jeffsponaugle/roscoe/V2/docs/V2ExpansionConntectorPinouts.pdf

PIN | DESC | DIR | PIN | DESC | DIR | PIN | DESC | DIR | PIN | DESC | DIR
A1 | EXP_A0 EXP_A2 EXP_A4 EXP_A6 | O | B1 | EXP_A1 EXP_A3 EXP_A5 EXP_A7 | O | C1 | EXP_D0 EXP_D2 EXP_D4 EXP_D6 | I/O | D1 | EXP_D1 EXP_D3 EXP_D5 EXP_D7 | I/O
A2 | | O | B2 | | O | C2 | | I/O | D2 | | I/O
A3 | | O | B3 | | O | C3 | | I/O | D3 | | I/O
A4 | | O | B4 | | O | C4 | | I/O | D4 | | I/O
A5 | EXP_A8 | O | B5 | EXP_A9 | O | C5 | GND | O | D5 | GND | O
A6 | EXP_A10 EXP_A12 EXP_A14 EXP_A16 | O | B6 | EXP_A11 EXP_A13 EXP_A15 EXP_A17 | O | C6 | EXP_D8 EXP_D10 EXP_D12 EXP_D14 | I/O | D6 | EXP_D9 EXP_D11 EXP_D13 EXP_D15 | I/O
A7 | | O | B7 | | O | C7 | | I/O | D7 | | I/O
A8 | | O | B8 | | O | C8 | | I/O | D8 | | I/O
A9 | | O | B9 | | O | C9 | | I/O | D9 | | I/O
A10 | VCC +5V | O | B10 | VCC +5V | O | C10 | EXP_D16 | I/O | D10 | EXP_D17 | I/O
A11 | EXP_A18 EXP_A20 EXP_A22 | O | B11 | EXP_A19 EXP_A21 EXP_A23 | O | C11 | EXP_D18 EXP_D20 EXP_D22 | I/O | D11 | EXP_D19 EXP_D21 EXP_D23 | I/O
A12 | | O | B12 | | O | C12 | | I/O | D12 | | I/O
A13 | | O | B13 | | O | C13 | | I/O | D13 | | I/O
A14 | EXP_A24 | O | B14 | EXP_A25 | O | C14 | VCC +5V | O | D14 | VCC +5V | O
A15 | EXP_A26 | O | B15 | EXP_A27 | O | C15 | EXP_D24 | I/O | D15 | EXP_D25 | I/O
A16 | GND | O | B16 | GND | O | C16 | EXP_D26 | I/O | D16 | EXP_D27 | I/O
A17 | EXP_A28 EXP_A30 | O | B17 | EXP_A29 EXP_A31 | O | C17 | EXP_D28 EXP_D30 | I/O | D17 | EXP_D29 EXP_D31 | I/O
A18 | | O | B18 | | O | C18 | | I/O | D18 | | I/O
A19 | EXP_RW EXP_16B_CS | O | B19 | EXP_8B_CS EXP_32B_CS | O
A20 | | O | B20 | | O
A21 EXP_VMEM_CS O | | | B21 | EXP_INT3A | I/PU
A22 | EXP_INT5D EXP_INT3B | I/PU | B22 | EXP_INT4C EXP_INT2B | I/PU
A23 | | I/PU | B23 | | I/PU
A24 | EXP_INT2A(VID) | I/PU | B24 | EXP_CPU_SIZE0 | O
A25 | EXP_CPU_AS | O | B25 EXP_CPU_SIZE1 O
A26 | EXP_nCPU_DEV_WAIT I/PU | | B26 | EXP_BC_CPLD1 | I/O
A27 | EXP_nDATA_EN | I/PU | B27 | EXP_CPU_CLK | O
A28 | EXP_CACHE_CTRL | I/PU | B28 | EXP_nSYS_RESET O
A29 | EXP_INT5A | I/PU | B29 | EXP_INT_CPLD2 I/O
A30 | EXP_VIO_CS | O | B30 | EXP_BC_CPLD2 | I/O
A31 | EXP_DM_CPLD1 | I/O | B31 | EXP_DM_CPLD2 I/O
