jeffsponaugle/roscoe/V2/docs/InterruptVectors.pdf

IRQ | System Use | MASK Address MASK ( 1= ENABLED, 0=DISABLED)
IRQL7A | 11110000 | (0xF0) | Debugger (Button) | 0x3000 0200 | 0b10000000
IRQL6A | 11100001 | (0xE1) | PTC #1 (Programmable Timer) | 0x3000 0200 | 0b01000000
IRQL6B | 11100010 | (0xE2) | PTC #2 (Programmable Timer) | 0x3000 0200 | 0b00100000
IRQL5A | 11010001 | (0xD1) | NIC | 0x3000 0200 | 0b00010000
IRQL5B | 11010010 | (0xD2) | IDE 1 | 0x3000 0200 | 0b00001000
IRQL5C | 11010100 | (0xD4) | IDE 2 | 0x3000 0200 | 0b00000100
IRQL5D | 11011000 | (0xD8) | EXPANSION_I5 | 0x3000 0200 | 0b00000010
IRQL4A | 11000001 | (0xC1) | UART 1 | 0x3000 0200 | 0b00000001
IRQL4B | 11000010 | (0xC2) | UART 2 | 0x3000 0201 | 0b10000000
IRQL4C | 11000100 | (0xC4) | EXPANSION_I4 | 0x3000 0201 | 0b01000000
IRQL3A | 10110001 | (0xB1) | USB | 0x3000 0201 | 0b00100000
IRQL3B | 10110010 | (0xB2) | EXPANSION_I3 | 0x3000 0201 | 0b00010000
IRQL2A | 10100001 | (0xA1) | VIDEO | 0x3000 0201 | 0b00001000
IRQL2B | 10100010 | (0xA2) | EXPANSION_I2 | 0x3000 0201 | 0b00000100
IRQL1A | 10010001 | (0x91) | RTC | 0x3000 0201 | 0b00000010
IRQL1B | 10010010 | (0x92) | POWER CONTROLLER | 0x3000 0201 | 0b00000001

MASK must be written with 8 bit writes (2 of them)

0x3000 0202 | Bit 0 = POWER OFF if == 1
| Bit 1 = SYSTEM RESET if == 1

Vector#
