jeffsponaugle/roscoe/V2/docs/Roscoe 68030 MemoryMap.xlsx

Sheet: MemoryMap(Current)
Memory Map |  |  |  |  |  |  | Smallest unit of device chip select is 256b (so a max of 24 address bits needed for decode). This could be increased to reduce decode complexity and reduce address lines needed in CPLD
REGION |  | SECTION
Start | Stop |  |  | Size/Spacing (in K) | Access | Type | Description
0x00000000 | 0x0FFFFFFF |  |  | 256MB |  | SYSTEM AND EXPANSION ROM AREA
 |  | 0x00000000 | 0x0007FFFF | #NUM! | R(W) | Primary System BIOS ( 8 bit access )
 |  | 0x00080000 | 0x000FFFFF | #NUM! | R(W) | Primary System BIOS ( 8 bit access ) [MIRROR]
 |  | 0x00010000 | 0x0FFFFFFF | #NUM! | R(W) | REPEAT EVERY 512K ^--
0x10000000 | 0x1FFFFFFF |  |  | 256MB |  | FAST SRAM AREA
 |  | 0x10000000 | 0x103FFFFF | 4MB | RW | 4MB of 0WS FAST SYNC SRAM (12ns)
 |  | 0x10400000 | 0x1FFFFFFF | 252MB |  | UNASSIGNED
0x20000000 | 0x2FFFFFFF |  |  | 256MB |  | EXTRA SRAM AREA
 |  | 0x20000000 | 0x2FFFFFFF | 256MB | RW | Unused in current design
0x30000000 | 0x3FFFFFFF |  |  | 256MB |  | 8-BIT DEVICE MAPPING
 |  | 0x30000000 | 0x300000FF | 256B | RW | TL16C2552 Dual UART A
 |  | 0x30000100 | 0x300001FF | 256B | RW | TL16C2552 Dual UART B
 |  | 0x30000200 | 0x30000201 | 2B | W | Interrupt Controller Interface | Interrupt Mask Register Byte Write to high,then low. 1=Enable Interrupt, 0=Disable Interrupt RESETs to all 0 0x30000200 bit 7 INT 7 INT_MSK15 bit 6 INT 6A INT_MSK14 bit 5 INT 6B INT_MSK13 bit 4 INT 5A INT_MSK12 bit 3 INT 5B INT_MSK11 bit 2 INT 5C INT_MSK10 bit 1 INT 5D INT_MSK9 bit 0 INT 4A INT_MSK8 0x30000201 bit 7 INT 4B INT_MSK7 bit 6 INT 4C INT_MSK6 bit 5 INT 3A INT_MSK5 bit 4 INT 3B INT_MSK4 bit 3 INT 2A INT_MSK3 bit 2 INT 2B INT_MSK2 bit 1 INT 1A INT_MSK1 bit 0 INT 1B INT_MSK0
 |  | 0x30000202 | 0x30000202 | 1B | W | Power and reset control | Bit 1 - 1=Reset system Bit 0 - 1=Power down system
 |  | 0x30000300 | 0x300003FF | 256B | RW | RTC + 114 byte RAM (DS12887/DS1687)
 |  | 0x30000400 | 0x300004FF | 256B | RW | UNUSED
 |  | 0x30000500 | 0x300005FF | 256B | RW | UNUSED ( for Video Controller Interface)
 |  | 0x30000600 | 0x300006FF | 256B | RW | Seven Segment Display, Left Character | D0-D7 = A,B,C,D,E,F,G,DP
 |  | 0x30000700 | 0x300007FF | 256B | RW | Seven Segment Display, Right Character | D0-D7 = A,B,C,D,E,F,G,DP
 |  | 0x30000800 | 0x300008FF | 256B | RW | 8 Status Board LEDs
0x40000000 | 0x4FFFFFFF |  |  | 256MB |  | 16-BIT DEVICE MAPPING
 |  | 0x40000000 | 0x400000FF | 256B | RW | IDE Interface #1A
 |  | 0x40000100 | 0x400001FF | 256B | RW | IDE Interface #1B
 |  | 0x40000200 | 0x400002FF | 256B | RW | IDE Interface #2A
 |  | 0x40000300 | 0x400003FF | 256B | RW | IDE Interface #2B
 |  | 0x40000400 | 0x400005FF | 512B | RW | PTC (Programmable Timer) CPLD
0x50000000 | 0x5FFFFFFF |  |  | 256MB | RW | 32-BIT DEVICE MAPPING
 |  | 0x50000000 | 0x500FFFFF | 1MB | RW | Reserved for VGA Display Memory
 |  | 0x50100000 | 0x501FFFFF | 1MB | RW | Reserved for VGA Font Memory
 |  | 0x50200000 | 0x50200FFF | 4096B | RW | Reserved for NIC MC9218 Ethernet Controller
0x60000000 | 0x7FFFFFFF |  |  | 512MB |  | UNALLOCATED
0x80000000 | 0xFFFFFFFF |  |  | 2GB |  | SYSTEM DRAM AREA
 |  | 0x80000000 | 0x9FFFFFFF | 512MB | RW | 4x128MB 60/70ns DRAM
 |  | 0xA0000000 | 0xFFFFFFFF | 1.5GB | RW | Expansion Interface DRAM

Sheet: VGATiming
 | dot_clock
 | HSYNC_SIGNAL |  | 0 | 1 | 2 | 3 | 4 | 5 | 6 | 7 | 8 | 9 | 10 | 11 | 12 | 13 | 14 | 15 | 16 |  | 17 |  | 18 |  | 19 |  | 20 |  | 21 |  | 22 |  | 23 |  | 24 |  | 25 |  | 26 |  | 27
 | mod32 |  | 0 | 1 | 2 | 3 | 4 | 5 | 6 | 7 | 8 | 9 | 10 | 11 | 12 | 13 | 14 | 15 | 16 |  | 17 |  | 18 |  | 19 |  | 20 |  | 21 |  | 22 |  | 23 |  | 24 |  | 25 |  | 26 |  | 27
 | mod16 |  | 0 | 1 | 2 | 3 | 4 | 5 | 6 | 7 | 8 | 9 | 10 | 11 | 12 | 13 | 14 | 15 | 0 |  | 1 |  | 2 |  | 3 |  | 4 |  | 5 |  | 6 |  | 7 |  | 8 |  | 9 |  | 10 |  | 11
 | mod8 |  | 0 | 1 | 2 | 3 | 4 | 5 | 6 | 7 | 0 | 1 | 2 | 3 | 4 | 5 | 6 | 7 | 0 |  | 1 |  | 2 |  | 3 |  | 4 |  | 5 |  | 6 |  | 7 |  | 0 |  | 1 |  | 2 |  | 3
 | hsync
 | pixel output |  |  |  |  |  |  |  |  |  |  |  |  |  |  |  |  |  |  | 0 |  | 1 |  | 2 |  | 3 |  | 4 |  | 5 |  | 6 |  | 7 |  | 8 |  | 9 |  | 10
TEXT_MODE |  |  |  |  |  |  |  |  |  |  |  |  |  |  |  |  |  |  |  |  | 1 |  |  |  |  |  |  |  |  |  |  |  |  |  |  |  | 2
(only line 0) | VMEM_ADDR_RESET | !((hsync_counter_field:['d'0]) & vsync_counter_field:['d'0]); |  | (only at the start of the FIRST line on the screen)
 | ADDR_MODE_ENABLE
 | VMEM_ADDR_MODE | ADDR_MODE1.d = 'b'0; ADDR_MODE0.d = ((hsync_counter_3_field:['d'0]) & !VM_ADDR_OE); | 00 | 00 | 00 | 00 | 00 | 00 | 00 | 00 | 00 | 00 | 00 | 00 | 00 | 00 | 00 | 00 | 01 |  | 00 |  | 00 |  | 00 |  | 00 |  | 00 |  | 00 |  | 00 |  | 01 |  | 00 |  | 00 |  | 00
 | nVMEM_ADDR_OE | !((hsync_counter_field:['d'8..'d'648]))
 | nVMEM_OE | use VMEM_ADDR_OE + VGA_BUSY
 | LATCH_VRAM | !((hsync_counter_3_field:['d'7])); |  |  |  |  |  |  |  |  |  |  |  |  |  |  |  |  | <--SREG latched from FONT Memory |  |  |  |  |  |  |  |  |  |  |  |  |  |  |  | <--SREG latched from FONT Memory
 | LATCH_SREG | !((hsync_counter_3_field:['d'0]) & !VM_ADDR_OE ); |  |  |  |  |  |  |  |  |  |  |  |  |  |  |  |  |  |  | <--SREG latched from FONT Memory |  |  |  |  |  |  |  |  |  |  |  |  |  |  |  | <--SREG latched from FONT Memory
 | SHIFT_SREG | !((hsync_counter_3_field:['d'1..'d'7]) & !VM_ADDR_OE );
 | SELECT_SUB |  |  |  |  |  |  |  |  |  | 00 | 00 | 00 | 00 | 00 | 00 | 00 | 00 | 00 |  | 00 |  | 00 |  | 00 |  | 00 |  | 00 |  | 00 |  | 00 |  | 00 |  | 00 |  | 00 |  | 00
 | VRAM_BUSY | (hsync_counter_field:['d'0..'d'639]) & VSYNC_DISPLAY_ACTIVE;
 | VGA_ENABLE |  |  |  |  |  |  |  |  |  |  |  |  |  |  |  |  |  |  |  |  |  |  |  | OUTPUT ENABLED
GRAPHICS MODE
(16bpp) | VMEM_ADDR_RESET | same as text
 | ADDR_MODE_ENABLE
 |  |  |  |  |  |  |  |  |  |  |  |  |  |  |  |  |  |  | 0 |  | 1 |  |  |  | 2 |  |  |  | 3 |  |  |  | 4 |  |  |  | 5 |  |  |  | 6
 | VMEM_ADDR_MODE | ADDR_MODE1.d = 'b'0; ADDR_MODE0.d = ((hsync_counter_3_field:['d'0,'d'2,'d'4,'d'6]) & !VM_ADDR_OE); | 00 | 00 | 00 | 00 | 00 | 00 | 00 | 00 | 00 | 00 | 00 | 00 | 00 | 00 | 00 | 00 | 01 |  | 00 |  | 01 |  | 00 |  | 01 |  | 00 |  | 01 |  | 00 |  | 01 |  | 00 |  | 01 |  | 00
 | nVMEM_ADDR_OE
 | nVMEM_OE
 | LATCH_VRAM
 | LATCH_SREG
 | SHIFT_SREG
 | SELECT_SUB |  |  |  |  |  |  |  |  |  | 00 | 00 | 00 | 00 | 00 | 00 | 00 | 00 | 00 |  | 01 |  | 00 |  | 01 |  | 00 |  | 01 |  | 00 |  | 01 |  | 00 |  | 01 |  | 00 |  | 01
 | VGA_ENABLE |  |  |  |  |  |  |  |  |  |  |  |  |  |  |  |  |  |  |  |  |  |  |  | OUTPUT ENABLED
GRAPHICS MODE
(8bpp) | VMEM_ADDR_RESET
 |  |  |  |  |  |  |  |  |  |  |  |  |  |  |  |  |  |  |  |  | 1 |  |  |  |  |  |  |  | 2 |  |  |  |  |  |  |  | 3
 | ADDR_MODE_ENABLE
 | VMEM_ADDR_MODE |  | 00 | 00 | 00 | 00 | 00 | 00 | 00 | 00 | 00 | 00 | 00 | 00 | 00 | 00 | 00 | 00 | 01 |  | 00 |  | 00 |  | 00 |  | 01 |  | 00 |  | 00 |  | 00 |  | 01 |  | 00 |  | 00 |  | 00
 | nVMEM_ADDR_OE
 | nVMEM_OE
 | LATCH_VRAM
 | LATCH_SREG
 | SHIFT_SREG
 | SELECT_SUB |  |  |  |  |  |  |  |  |  | 00 | 00 | 00 | 00 | 00 | 00 | 00 | 00 | 00 |  | 01 |  | 10 |  | 11 |  | 00 |  | 01 |  | 10 |  | 11 |  | 00 |  | 01 |  | 10 |  | 11
 | VGA_ENABLE |  |  |  |  |  |  |  |  |  |  |  |  |  |  |  |  |  |  |  |  |  |  |  | OUTPUT ENABLED

Sheet: InterruptVectors(current)
IRQ | Vector# |  | System Use | MASK Address | MASK ( 1= ENABLED, 0=DISABLED)
IRQL7A | 11110000 | (0xF0) | Debugger (Button) | 0x3000 0200 | 0b10000000
IRQL6A | 11100001 | (0xE1) | PTC #1 (Programmable Timer) | 0x3000 0200 | 0b01000000
IRQL6B | 11100010 | (0xE2) | PTC #2 (Programmable Timer) | 0x3000 0200 | 0b00100000
IRQL5A | 11010001 | (0xD1) | NIC | 0x3000 0200 | 0b00010000
IRQL5B | 11010010 | (0xD2) | IDE 1 | 0x3000 0200 | 0b00001000
IRQL5C | 11010100 | (0xD4) | IDE 2 | 0x3000 0200 | 0b00000100
IRQL5D | 11011000 | (0xD8) | EXPANSION_I5 | 0x3000 0200 | 0b00000010
IRQL4A | 11000001 | (0xC1) | UART 1 | 0x3000 0200 | 0b00000001
IRQL4B | 11000010 | (0xC2) | UART 2 | 0x3000 0201 | 0b10000000
IRQL4C | 11000100 | (0xC4) | EXPANSION_I4 | 0x3000 0201 | 0b01000000
IRQL3A | 10110001 | (0xB1) | USB | 0x3000 0201 | 0b00100000
IRQL3B | 10110010 | (0xB2) | EXPANSION_I3 | 0x3000 0201 | 0b00010000
IRQL2A | 10100001 | (0xA1) | VIDEO | 0x3000 0201 | 0b00001000
IRQL2B | 10100010 | (0xA2) | EXPANSION_I2 | 0x3000 0201 | 0b00000100
IRQL1A | 10010001 | (0x91) | RTC | 0x3000 0201 | 0b00000010
IRQL1B | 10010010 | (0x92) | POWER CONTROLLER | 0x3000 0201 | 0b00000001
 |  |  |  | MASK must be written with 8 bit writes (2 of them)
 |  |  |  | 0x3000 0202 | Bit 0 = POWER OFF if == 1
 |  |  |  |  | Bit 1 = SYSTEM RESET if == 1

Sheet: V2ExpansionConnector
PIN | DESC | DIR | PIN | DESC | DIR | PIN | DESC | DIR | PIN | DESC | DIR
A1 | EXP_A0 | O | B1 | EXP_A1 | O | C1 | EXP_D0 | I/O | D1 | EXP_D1 | I/O
A2 | EXP_A2 | O | B2 | EXP_A3 | O | C2 | EXP_D2 | I/O | D2 | EXP_D3 | I/O
A3 | EXP_A4 | O | B3 | EXP_A5 | O | C3 | EXP_D4 | I/O | D3 | EXP_D5 | I/O
A4 | EXP_A6 | O | B4 | EXP_A7 | O | C4 | EXP_D6 | I/O | D4 | EXP_D7 | I/O
A5 | EXP_A8 | O | B5 | EXP_A9 | O | C5 | GND | O | D5 | GND | O
A6 | EXP_A10 | O | B6 | EXP_A11 | O | C6 | EXP_D8 | I/O | D6 | EXP_D9 | I/O
A7 | EXP_A12 | O | B7 | EXP_A13 | O | C7 | EXP_D10 | I/O | D7 | EXP_D11 | I/O
A8 | EXP_A14 | O | B8 | EXP_A15 | O | C8 | EXP_D12 | I/O | D8 | EXP_D13 | I/O
A9 | EXP_A16 | O | B9 | EXP_A17 | O | C9 | EXP_D14 | I/O | D9 | EXP_D15 | I/O
A10 | VCC +5V | O | B10 | VCC +5V | O | C10 | EXP_D16 | I/O | D10 | EXP_D17 | I/O
A11 | EXP_A18 | O | B11 | EXP_A19 | O | C11 | EXP_D18 | I/O | D11 | EXP_D19 | I/O
A12 | EXP_A20 | O | B12 | EXP_A21 | O | C12 | EXP_D20 | I/O | D12 | EXP_D21 | I/O
A13 | EXP_A22 | O | B13 | EXP_A23 | O | C13 | EXP_D22 | I/O | D13 | EXP_D23 | I/O
A14 | EXP_A24 | O | B14 | EXP_A25 | O | C14 | VCC +5V | O | D14 | VCC +5V | O
A15 | EXP_A26 | O | B15 | EXP_A27 | O | C15 | EXP_D24 | I/O | D15 | EXP_D25 | I/O
A16 | GND | O | B16 | GND | O | C16 | EXP_D26 | I/O | D16 | EXP_D27 | I/O
A17 | EXP_A28 | O | B17 | EXP_A29 | O | C17 | EXP_D28 | I/O | D17 | EXP_D29 | I/O
A18 | EXP_A30 | O | B18 | EXP_A31 | O | C18 | EXP_D30 | I/O | D18 | EXP_D31 | I/O
A19 | EXP_RW | O | B19 | EXP_8B_CS | O
A20 | EXP_16B_CS | O | B20 | EXP_32B_CS | O
A21 | EXP_VMEM_CS | O | B21 | EXP_INT3A | I/PU
A22 | EXP_INT5D | I/PU | B22 | EXP_INT4C | I/PU
A23 | EXP_INT3B | I/PU | B23 | EXP_INT2B | I/PU
A24 | EXP_INT2A(VID) | I/PU | B24 | EXP_CPU_SIZE0 | O
A25 | EXP_CPU_AS | O | B25 | EXP_CPU_SIZE1 | O
A26 | EXP_nCPU_DEV_WAIT | I/PU | B26 | EXP_BC_CPLD1 | I/O
A27 | EXP_nDATA_EN | I/PU | B27 | EXP_CPU_CLK | O
A28 | EXP_CACHE_CTRL | I/PU | B28 | EXP_nSYS_RESET | O
A29 | EXP_INT5A | I/PU | B29 | EXP_INT_CPLD2 | I/O
A30 | EXP_VIO_CS | O | B30 | EXP_BC_CPLD2 | I/O
A31 | EXP_DM_CPLD1 | I/O | B31 | EXP_DM_CPLD2 | I/O
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
