jeffsponaugle/roscoe/V2/docs/DebugPinouts.xlsx

 | PinName | Pin# | Signal
U69 | D0 | 19 | D30 | U23 | D0 | 19 | D14 | U24 | D0 | 19 | A30 | U25 | D0 | 19 | A14
 | D1 | 18 | D31 |  | D1 | 18 | D15 |  | D1 | 18 | A31 |  | D1 | 18 | A15
 | D2 | 17 | D28 |  | D2 | 17 | D12 |  | D2 | 17 | A28 |  | D2 | 17 | A12
 | D3 | 16 | D29 |  | D3 | 16 | D13 |  | D3 | 16 | A29 |  | D3 | 16 | A13
 | D4 | 15 | D26 |  | D4 | 15 | D10 |  | D4 | 15 | A26 |  | D4 | 15 | A10
 | D5 | 14 | D27 |  | D5 | 14 | D11 |  | D5 | 14 | A27 |  | D5 | 14 | A11
 | D6 | 13 | D24 |  | D6 | 13 | D8 |  | D6 | 13 | A24 |  | D6 | 13 | A8
 | D7 | 12 | D25 |  | D7 | 12 | D9 |  | D7 | 12 | A25 |  | D7 | 12 | A9
 | D8 | 11 | D22 |  | D8 | 11 | D6 |  | D8 | 11 | A22 |  | D8 | 11 | A6
 | D9 | 10 | D23 |  | D9 | 10 | D7 |  | D9 | 10 | A23 |  | D9 | 10 | A7
 | D10 | 9 | D20 |  | D10 | 9 | D4 |  | D10 | 9 | A20 |  | D10 | 9 | A4
 | D11 | 8 | D21 |  | D11 | 8 | D5 |  | D11 | 8 | A21 |  | D11 | 8 | A5
 | D12 | 7 | D18 |  | D12 | 7 | D2 |  | D12 | 7 | A18 |  | D12 | 7 | A2
 | D13 | 6 | D19 |  | D13 | 6 | D3 |  | D13 | 6 | A19 |  | D13 | 6 | A3
 | D14 | 5 | D16 |  | D14 | 5 | D0 |  | D14 | 5 | A16 |  | D14 | 5 | A0
 | D15 | 4 | D17 |  | D15 | 4 | D1 |  | D15 | 4 | A17 |  | D15 | 4 | A1
 | CLK1 | 3 | EXP_BC_CPLD1 |  | CLK1 | 3 | EXP_DM_CPLD1 |  | CLK1 | 3 | EXP_DM_CPLD1 |  | CLK1 | 3
 | CLK2 | 2 | EXP_BC_CPLD2 |  | CLK2 | 2 | EXP_DM_CPLD2 |  | CLK2 | 2 | EXP_DM_CPLD2 |  | CLK2 | 2
U5 | D0 | 19 | DRAM_MUX
 | D1 | 18 | nDRAM_DATA_EN
 | D2 | 17 | nDRAM_WE
 | D3 | 16 | nDRAM_CAS0
 | D4 | 15 | nDRAM_CAS1
 | D5 | 14 | nDRAM_CAS2
 | D6 | 13 | nDRAM_CAS3
 | D7 | 12 | nDRAM_S1A_RAS
 | D8 | 11 | nDRAM_S1B_RAS
 | D9 | 10 | nDRAM_S2A_RAS
 | D10 | 9 | nDRAM_S2B_RAS
 | D11 | 8 | nDRAM_S3A_RAS
 | D12 | 7 | nDRAM_S3B_RAS
 | D13 | 6 | nDRAM_S4A_RAS
 | D14 | 5 | nDRAM_S4B_RAS
 | D15 | 4 | EXTRA_BC_DM1
 | CLK1 | 3
 | CLK2 | 2
U7 | D0 | 19 | nSRAM_UL_SEL | U5 | D0 | 19
 | D1 | 18 | nSRAM_UH_SEL |  | D1 | 18 | nPTC_CS
 | D2 | 17 | nSRAM_LL_SEL |  | D2 | 17 | nIDE_WR
 | D3 | 16 | nSRAM_LH_SEL |  | D3 | 16 | nIDE1_BUFFER_EN
 | D4 | 15 | nSRAM_BANK1_CE |  | D4 | 15 | nIDE1_Csa
 | D5 | 14 | nCPU_STERM |  | D5 | 14 | nFPU_CS
 | D6 | 13 | nSYS_RESET |  | D6 | 13 | nSTATUSLED_WR
 | D7 | 12 | nCPU_IPL2 |  | D7 | 12 | nSRAM_BANK4_CE
 | D8 | 11 | nCPU_IPL1 |  | D8 | 11 | nSRAM_BANK3_CE
 | D9 | 10 | nCPU_IPL0 |  | D9 | 10 | nSRAM_BANK2_CE
 | D10 | 9 | nCPU_DSACK1 |  | D10 | 9 | CPU_FC2
 | D11 | 8 | nCPU_DSACK0 |  | D11 | 8 | CPU_FC1
 | D12 | 7 | CPU_SIZ1 |  | D12 | 7 | CPU_FC0
 | D13 | 6 | CPU_SIZ0 |  | D13 | 6 | nCPU_CIIN
 | D14 | 5 | CPU_RW |  | D14 | 5 | nCPU_HALT
 | D15 | 4 | nCPU_AS |  | D15 | 4 | nCPU_BERR
 | CLK1 | 3 | CPU_CLK |  | CLK1 | 3
 | CLK2 | 2 |  |  | CLK2 | 2
