jeffsponaugle/roscoe/V2/schematic/RoscoeMainboardV2Final.csv

# | Name | Manufacturer | Quantity | RefDes | Value | Part | Number of Pins | Pattern
1 | CAP_0805 |  | 70 | C1, C4, C5, C6, C7, C8, C9, C10, C11, C12, C13, C14, C15, C28, C29, C30, C31, C32, C33, C34, C35, C36, C37, C38, C39, C40, C41, C42, C43, C44, C45, C46, C47, C48, C49, C50, C51, C52, C53, C54, C55, C56, C57, C81, C84, C85, C86, C87, C88, C89, C90, C91, C92, C93, C94, C95, C96, C97, C98, C99, C100, C101, C102, C104, C110, C111, C112, C113, C114, C115 | 0.1uf | Part 1 | 2 | CAP_0805
2 | CAP_0805 |  | 7 | C2, C3, C16, C17, C18, C19, C20 | 1uF | Part 1 | 2 | CAP_0805
3 | CAP_0805 |  | 1 | C27 | .1uF | Part 1 | 2 | CAP_0805
4 | LED_0805 |  | 1 | D1 | RESET | Part 1 | 2 | DIO_0805
5 | LED_0805 |  | 1 | D2 | HALT | Part 1 | 2 | DIO_0805
6 | P0 |  | 1 | D3 |  | Part 1 | 2 | DIO_0805
7 | LED_0805 |  | 1 | D4 | ATX_PWR | Part 1 | 2 | DIO_0805
8 | LED_0805 |  | 1 | D5 | MAIN_PWR | Part 1 | 2 | DIO_0805
9 | P1 |  | 1 | D6 |  | Part 1 | 2 | DIO_0805
10 | P2 |  | 1 | D7 |  | Part 1 | 2 | DIO_0805
11 | P3 |  | 1 | D8 |  | Part 1 | 2 | DIO_0805
12 | P4 |  | 1 | D9 |  | Part 1 | 2 | DIO_0805
13 | P5 |  | 1 | D10 |  | Part 1 | 2 | DIO_0805
14 | P6 |  | 1 | D11 |  | Part 1 | 2 | DIO_0805
15 | P7 |  | 1 | D12 |  | Part 1 | 2 | DIO_0805
16 | SPARELED1 |  | 1 | D13 |  | Part 1 | 2 | DIO_0805
17 | SPARELED2 |  | 1 | D14 |  | Part 1 | 2 | DIO_0805
18 | LTS-4801 | Lite-On Optoelectronics | 2 | DS1, DS2 | Yellow7Seg | Part 1 | 10 | LITEON_LSHD-A1010
19 | HDR-2x5 |  | 2 | J1, J11 | JTAG | Part 1 | 10 | HDR-2x5
20 | HDR-1x2 |  | 1 | J2 | CMOSCLR | Part 1 | 2 | HDR-1x2
21 | HDR-1x3 |  | 1 | J3 | RAMSIZE | Part 1 | 3 | HDR-1x3
22 | IDE_HDR-2x20 |  | 1 | J4 | IDE1 | Part 1 | 40 | HDR-2x20
23 | HDR-1x2 |  | 1 | J5 | IDE1PWR | Part 1 | 2 | HDR-1x2
24 | IDE_HDR-2x20 |  | 1 | J6 | IDE2 | Part 1 | 40 | HDR-2x20
25 | HDR-1x2 |  | 1 | J7 | IDE2PWR | Part 1 | 2 | HDR-1x2
26 | HDR-1x2 |  | 1 | J8 | JT1 | Part 1 | 2 | HDR-1x2
27 | HDR-1x2 |  | 1 | J9 | JT2 | Part 1 | 2 | HDR-1x2
28 | HDR-1x2 |  | 1 | J10 | TDI | Part 1 | 2 | HDR-1x2
29 | SPARELED |  | 1 | J12 | IDE1PWR | Part 1 | 2 | HDR-1x2
30 | HDR-1x2 |  | 1 | J17 | RESET | Part 1 | 2 | HDR-1x2
31 | HDR-1x2 |  | 1 | J18 | POWER | Part 1 | 2 | HDR-1x2
32 | HDR-2x3 |  | 1 | J19 | INTTETP0 | Part 1 | 6 | HDR-2x3
33 | HDR-2x5 |  | 1 | J20 | UARTB | Part 1 | 10 | HDR-2x5
34 | HDR-1x3 |  | 1 | J21 | RIA/BOOOTSEL | Part 1 | 3 | HDR-1x3
35 | HDR-1x2 |  | 1 | J23 | PULUPS | Part 1 | 2 | HDR-1x2
36 | HDR-1x3 |  | 1 | J24 | POWERREQ | Part 1 | 3 | HDR-1x3
37 | HDR-1x2 |  | 1 | J25 | RSTOUT | Part 1 | 2 | HDR-1x2
38 | HDR-1x2 |  | 1 | J26 | TDO | Part 1 | 2 | HDR-1x2
39 | HDR-1x3 |  | 1 | J27 | INTTESTP | Part 1 | 3 | HDR-1x3
40 | HDR-1x3 |  | 1 | J28 | DMTESTP | Part 1 | 3 | HDR-1x3
41 | HDR-1x4 |  | 1 | J29 | BCTESTP | Part 1 | 4 | HDR-1x4
42 | HDR-1x4 |  | 1 | J30 | PWR | Part 1 | 4 | HDR-1x4
43 | HDR-1x4 |  | 1 | J31 | PWR3V | Part 1 | 4 | HDR-1x4
44 | HDR-2x5 |  | 1 | J301 | UARTA | Part 1 | 10 | HDR-2x5
45 | RES_0805 |  | 14 | R1, R2, R3, R7, R8, R9, R17, R47, R49, R50, R51, R52, R56, R57 | 10K | Part 1 | 2 | RES_0805
46 | RES_0805 |  | 1 | R4 | 2k | Part 1 | 2 | RES_0805
47 | RES_0805 |  | 20 | R5, R6, R13, R14, R15, R23, R24, R25, R26, R27, R28, R29, R30, R31, R32, R33, R34, R35, R42, R43 | 240 | Part 1 | 2 | RES_0805
48 | RES_0805 |  | 15 | R10, R11, R12, R18, R19, R20, R21, R22, R41, R44, R45, R46, R48, R58, R59 | 10k | Part 1 | 2 | RES_0805
49 | RES_0805 |  | 1 | R16 | 1K | Part 1 | 2 | RES_0805
50 | RP0 |  | 3 | R36, R60, R61 | 240 | Part 1 | 2 | RES_0805
51 | RP1 |  | 1 | R37 | 240 | Part 1 | 2 | RES_0805
52 | RP2 |  | 1 | R38 | 240 | Part 1 | 2 | RES_0805
53 | RP3 |  | 1 | R39 | 240 | Part 1 | 2 | RES_0805
54 | RP4 |  | 1 | R40 | 240 | Part 1 | 2 | RES_0805
55 | RP5 |  | 1 | R53 | 240 | Part 1 | 2 | RES_0805
56 | RP6 |  | 1 | R54 | 240 | Part 1 | 2 | RES_0805
57 | RP7 |  | 1 | R55 | 240 | Part 1 | 2 | RES_0805
58 | RES11SIPB |  | 1 | R301 | 100k | Part 1 | 11 | HDR-1x11
59 | 74HC04D | Philips/NXP | 1 | U1 |  | Part 1 | 14 | SOIC14P127_865X600X175L70X42N
60 | MC68030 |  | 1 | U2 |  | Part 1 | 128 | PGA1313
61 | SST39SF010A EEPROM |  | 1 | U3 |  | Part 1 | 32 | DIP-32/600mil-FLSH
62 | LOGICA |  | 1 | U4 | CPUDBB | Part 1 | 20 | LOGICA-HDR-2x10
63 | LOGICA |  | 2 | U5, U25 | EXPBUSD | Part 1 | 20 | LOGICA-HDR-2x10
64 | SRAM_PCB_CONN |  | 1 | U6 |  | Part 1 | 64 | PCN10-64P-2.54DSA(72)
65 | 74HC273D | Philips/NXP | 3 | U7, U9, U10 |  | Part 1 | 20 | SOIC20P127_1280X1032X265L75X42N
66 | PROBE |  | 1 | U8 | CPU_CLK | Part 1 | 1 | TESTPORT
67 | PTC-ATF1504 |  | 1 | U11 |  | Part 1 | 44 | QFP44P80_1200X1200X120L60X37L
68 | 32768-OSC |  | 1 | U12 |  | Part 1 | 4 | OSC-3.2x2.5
69 | OSC-18432-SMD |  | 1 | U13 |  | Part 1 | 4 | SG5032-OSC-5x3.2
70 | 72SIMM-DRAM |  | 4 | U18, U19, U20, U21 |  | Part 1 | 72 | 72SIMM-90Deg
71 | 68882 |  | 1 | U22 |  | Part 1 | 68 | 68PLCC_Socket
72 | LOGICA |  | 1 | U23 | EXPBUSB | Part 1 | 20 | LOGICA-HDR-2x10
73 | LOGICA |  | 1 | U24 | EXPBUSC | Part 1 | 20 | LOGICA-HDR-2x10
74 | SN74AHC157D | Texas Instruments | 3 | U26, U27, U28 | DRAM_MUX | Part 1 | 16 | SOIC16P127_990X600X175L83X41N_AD4
75 | 74HCT245D | Philips/NXP | 4 | U29, U30, U31, U32 | DRAM_BUFFER | Part 1 | 20 | SOIC20P127_1280X1032X265L75X42N
76 | DS12887 |  | 1 | U33 |  | Part 1 | 24 | DIP-24/600mil
77 | 74AHC244D | Philips/NXP | 1 | U34 | RTC_BUF | Part 1 | 20 | SOIC20P127_1280X1032X265L75X42N
78 | SN74AHC245DW | Texas Instruments | 1 | U35 | RTC_BUF | Part 1 | 20 | SOIC20P127_1280X1030X265L83X41N_AD2
79 | ST16C2550 |  | 1 | U36 |  | Part 1 | 44 | 44PLCCSocket
80 | SN74AHC245DW | Texas Instruments | 2 | U37, U38 | IDE1_BUF | Part 1 | 20 | SOIC20P127_1280X1030X265L83X41N_AD2
81 | 74AHC244D | Philips/NXP | 1 | U39 | IDE1_BUF | Part 1 | 20 | SOIC20P127_1280X1032X265L75X42N
82 | SN74AHC245DW | Texas Instruments | 2 | U40, U41 | IDE2_BUF | Part 1 | 20 | SOIC20P127_1280X1030X265L83X41N_AD2
83 | 74AHC244D | Philips/NXP | 1 | U42 | IDE2_BUF | Part 1 | 20 | SOIC20P127_1280X1032X265L75X42N
84 | EXP_BUS_SLOT |  | 1 | U46 | SLOT1 | Part 1 | 98 | 16BIT_ISA_SOCKET
85 | EXP_BUS_SLOT |  | 1 | U47 | SLOT2 | Part 1 | 98 | 16BIT_ISA_SOCKET
86 | EXP_BUS_SLOT |  | 1 | U48 | SLOT3 | Part 1 | 98 | 16BIT_ISA_SOCKET
87 | 74AHC244D | Philips/NXP | 6 | U49, U50, U51, U52, U53, U68 | EXP_BUF | Part 1 | 20 | SOIC20P127_1280X1032X265L75X42N
88 | SN74AHC245DW | Texas Instruments | 4 | U54, U55, U56, U57 | EXP_BUF | Part 1 | 20 | SOIC20P127_1280X1030X265L83X41N_AD2
89 | BUSCTRL-ATF1508V2 |  | 1 | U58 | BUSCTRL | Part 1 | 100 | QFP100P50_1600X1600X120L60X22L
90 | DEVDCD-ATF1508V2 |  | 1 | U59 | DEVDCD | Part 1 | 100 | QFP100P50_1600X1600X120L60X22L
91 | INTCTRL-ATF1508V2 |  | 1 | U60 | INTCTRL | Part 1 | 100 | QFP100P50_1600X1600X120L60X22L
92 | ATXPOWERIN |  | 1 | U64 |  | Part 1 | 24 | ATXPOWER
93 | POWER_CONTROLLER |  | 1 | U65 |  | Part 1 | 14 | SOIC-14/150mil
94 | TactSwitch |  | 1 | U66 | RESET | Part 1 | 4 | 1825910 Series Switch
95 | TactSwitch |  | 1 | U67 | POWER | Part 1 | 4 | 1825910 Series Switch
96 | LOGICA |  | 1 | U69 | EXPBUSA | Part 1 | 20 | LOGICA-HDR-2x10
97 | LOGICA |  | 1 | U70 | CPUDBA | Part 1 | 20 | LOGICA-HDR-2x10
98 | TactSwitch |  | 1 | U901 |  | Part 1 | 4 | 1825910 Series Switch
99 | XO08 | CN Electronics | 1 | Y1 | 20MHz | Part 1 | 4 | OSC762W46P254L1321H595Q4
 |  |  | 245 |  |  |  | 2565
