jeffsponaugle/roscoe/src/Roscoe/PowerControlModule/Power Control Module theory of operation.docx

# Power Management Controller (PMC) theory of operation

This document outlines the theory of operation behind the power management controller (PMC). It has the following features:

- Provides reset and power button debouncing
- Controlled power up with assert of PSON, monitoring of PWROK, and a clean reset release
- Controlled power down capabilities (cooperation with the host OS)
- Immediate power off/assert of reset if PWROK deasserts while power is on
- Power state retention

# Connectivity

The PMC is based on the Atmel ATTiny24A CPU, chosen specifically because of its connectivity and flash/RAM resources. The PMC is designed to handle ATX power control, monitoring, and host reset. Pinout/connectivity to the ATTINY24 is as follows:

Pin | Description
1 | VCC (3.3-5V) – Provide the controller +3.3-5V standby voltage so it’s always on even when the host isn’t
2 | PSON – Signal to the power supply to turn it on (active low signal). Wire directly to PSON on the ATX supply.
3 | Spare – Spare debug signal – currently high and unused.
4 | !RESET – AVR Reset. Tie to +5VSB with a 10k resistor per AVR spec.
5 | PWRGRRQ – Power state request/grant control signal. Should be wired directly to the CPLD and monitored in hardware on falling edges (active low).
6 | PWROK – Signal from the power supply indicating a good power/operating condition (active high signal). Wire directly to PWR_OK on the ATX power supply. This is monitored as a hardware interrupt/falling edge in code for power supply faults.
7 | MOSI – SPI Interface for programming
8 | MISO – SPI Interface for programming
9 | SCK – SPI Interface for programming
10 | SYSRESETN – Open collector active low reset to reset the host CPU. Should be tied directly to the system’s reset line.
11 | Power LED – Active low/sink (for LED on) for CPU controlled “power” LED, to indicate fault conditions. Recommend wiring standby voltage to this LED as well so indication can be conveyed with host power off.
12 | Reset button – Wire directly to chassis reset button. Active low/grounded.
13 | Power button - Wire directly to chassis reset button. Active low/grounded.
14 | Ground

# Firmware

The PMC’s firmware is written in straight C using Microchip Studio, and is contained within a single module – main.c, and consumes about 1.7k of the on-chip flash.

Power/reset button reading and power LED state setting is accomplished inside timer 0’s interrupt service routine, which fires 100 times a second. The ISR is in TIM_COMPA_vect. This ISR handles debounce of the reset and power buttons, as well as setting the state of the power LED (such as blinking it when necessary, etc…). It sets global Booleans for various functions, such as a power state request, reset request, etc… which is picked up by main() in foreground.

The PWR_GOOD signal is monitored as an interrupt, and each time it changes state, PCINT0_vect is called. On a high to low transition, host reset is asserted and PSON is deasserted to shut the supply off. This is interrupt driven instead of polled so the firmware can react with a reset and deassertion of PSON as quickly as possible to help minimize the possibility of host data corruption.

The PWRGRRQ signal is for communication of coordinated power down with the host, and is also monitored as an INT0 external falling edge interrupt. When a falling edge is detected, EXT_INT0_vect is called. In a powered-on situation, this initial signal going low initially signals a desire for the host to put the PMC in controlled shutdown mode. From this point on, pressing the power button is considered a power request and the PMC will pull this line low to the host so it can generate whatever signaling is necessary for a powerdown request. Once the host is ready to power down, it can again pull this signal low, which causes a shutdown.

Only the first byte of the EEPROM is used to determine power state retention. The EEPROM is accessible via EEPROMRead() and EEPROMWrite(). Before EEPROMWrite() is called, ensure that EEPROMBusy() returns “false”. Note that EEPROMBusy() isn’t part of the read/write code so that other tasks can be performed while the EEPROM is busy and not stuck for 10s of milliseconds waiting for the operations to complete.

Entry is in main(). The firmware is designed to not disturb the state of any pins so as to not glitch the power supply to the host should the PMC reset. In normal operation, this shouldn’t ever happen. In main(), there is an endless superloop in a for (;;) that is a power/reset control state machine. This is where all of the decisions are made and control flow happens.

# Power LED states

The power LED’s states have the following meaning:

- Off – Host power is turned off
- Steady on – Host power is turned on and stable
- Slow 50/50% blink – Waiting for a PWR_GOOD signal from the power supply on a power up *OR* a controlled shutdown has been signaled by the host and someone has pressed the power button.
- Two fast blinks, pause – PWR_GOOD was lost unexpectedly, or failed to power up (no PWR_GOOD signal). This state is cleared on the next power cycle attempt

# Startup operation

As mentioned earlier, program execution starts in main(). The first step is to stop all interrupts and set up all input pins as inputs with appropriate pullups. PWR_OK is sampled on startup, and if PWR_OK is asserted, PSON is forced low to keep the supply on and host reset is not asserted. If PWR_OK is off at startup, PSON is tristated and host reset is asserted.

Other signals are set up, including outputs, like the power and spare LED drives. The internal clock prescaler is changed from /8 to /1 so the CPU will run @ 8Mhz. Then timer 0 is initialized to generate a periodic interrupt which handles all of the button inputs and LED outputs.

After interrupts are enabled, the state machine is entered. Default state is ESTATE_INIT, which reads the first byte of the EEPROM to check what the power state retention policy should be. If the power was off before, it advances to ESTATE_POWER_OFF, and if on, to ESTATE_POWER_ON.

The ESTATE_MONITOR state is where the CPU spends the overwhelming majority of its time. It’s looking for power state transitions and handling of fault situations, etc…

# Power up procedure

The power-on procedure, regardless of its source (button press, power state retention, etc…), is as follows:

1) State is set to ESTATE_POWER_ON.
2) Disable power grant/request and PWR_OK interrupts since the host is not powered
3) Assert reset (drive low)
4) Set the “alert state” to “power state change”
5) Assert PSON (drive low)
6) Sample the timer ticks. Jump to ESTATE_WAIT_PWROK.
7) If PWR_OK doesn’t go high within PSON_TO_PWROK milliseconds of PWR_ON, set a power fault condition and turn power off again (ESTATE_POWER_OFF)
8) Assuming PWR_OK asserts, deassert host reset, and advanced to ESTATE_WAIT_RESET_DEASSERT and wait PWROK_TO_RESET milliseconds before beginning to monitor PWR_OK and PWRGRRQ signals.
9) The system is considered powered up at this point, and jumps to ESTATE_MONITOR state.

# Uncontrolled power down procedure

The uncontrolled power-down procedure operates as follows:

1) State is set to ESTATE_POWER_OFF.
2) Disable power grant/request and PWR_OK interrupts since the host will no longer be powered.
3) Host reset is asserted (driven low)
4) PSON deasserted (tristated)
5) PWRGRRQ is set as an input (tristated)
6) At this point it will reenter this state until PWR_OK deasserts
7) Power is now considered turned off at this point and jumps back to ESTATE_MONITOR.

# Controlled power down procedure

Controlled power down gives the opportunity for the PMC to indicate to the host that a power down has been requested, and a method for the host to tell the PMC to turn off power. This mode is cleared automatically every time the system is powered off. Controlled power down is the same as uncontrolled power down, but is a bit more complicated:

1) Host provides a falling edge to the PMC on the PWRGRRQ signal. This puts the PMC in “controlled power down” mode. That mode is set by an interrupt call to EXT_INT0_vect when the PWRGRRQ signal transitions from high to low.
2) User presses the power button. The PMC pulls PWRGRRQ low to indicate to the host that a power down request has been initiated. Power button presses until the next power down will result in a pulse.
3) When the host computer is ready to power the system down, it pulls PWRGRRQ low for a second time. The EXT_INT0_vect is called and sg_bCoordinatedShutdown and sg_bPowerRequest are both set true. ESTATE_MONITOR picks up on this and shuts the system down and clears controlled power down mode.

# Tuneables

There are many #defines in code that can be tweaked for specific performance. The pertinent/interesting ones are as follows:

- CPU_SPEED – In hz, the CPU’s actual core speed. The code is set up to set the internally 8Mhz oscillator to /1. Changing this value will not change the CPU’s speed. The CPU’s clock divisor is changed by the CLKPR changes.
- TIMER_PRESCALER – Prescaler for the timer from the main CPU speed. It’s set in code as /1024 in TCCR0B, so as with the CPU speed, if the TCCR0B prescaler is changed, TIMER_PRESCALER needs to be changed as well, as it won’t happen automatically.
- TIMER_FREQ – How fast are our timer ticks? In hz. This timer is used to poll reset/power buttons and set the power LED state. Set to 100hz, or 10ms intervals. This is a changeable value, however it does have its limits. Too high or too low will result in rounding issues.
- PSON_TO_PWROK – In milliseconds – how long should we wait for PWR_OK to be asserted after PSON is asserted?
- PWROK_TO_RESET – In milliseconds – Amount of time after PWR_OK is asserted to wait until reset gets deasserted and the system is considered powered up.
- BUTTON_DEBOUNCE – In milliseconds – Amount of time a button must be pressed or released until it’s considered pressed or released.
- POWER_BUTTON_OVERRIDE – In milliseconds – When in controlled shutdown mode, this is how long the power button must be held in order to forcibly shut the system down. Think of it being similar to the 4 second power button override ala ACPI.
- POWER_REQUEST_TIME – In milliseconds – When In controlled shutdown mode, this is how long the high->low->high pulse is on the . This signals the host that a power down request has been made.
