jeffsponaugle/roscoe/schematic/RoscoeMainboardV2Final.pdf

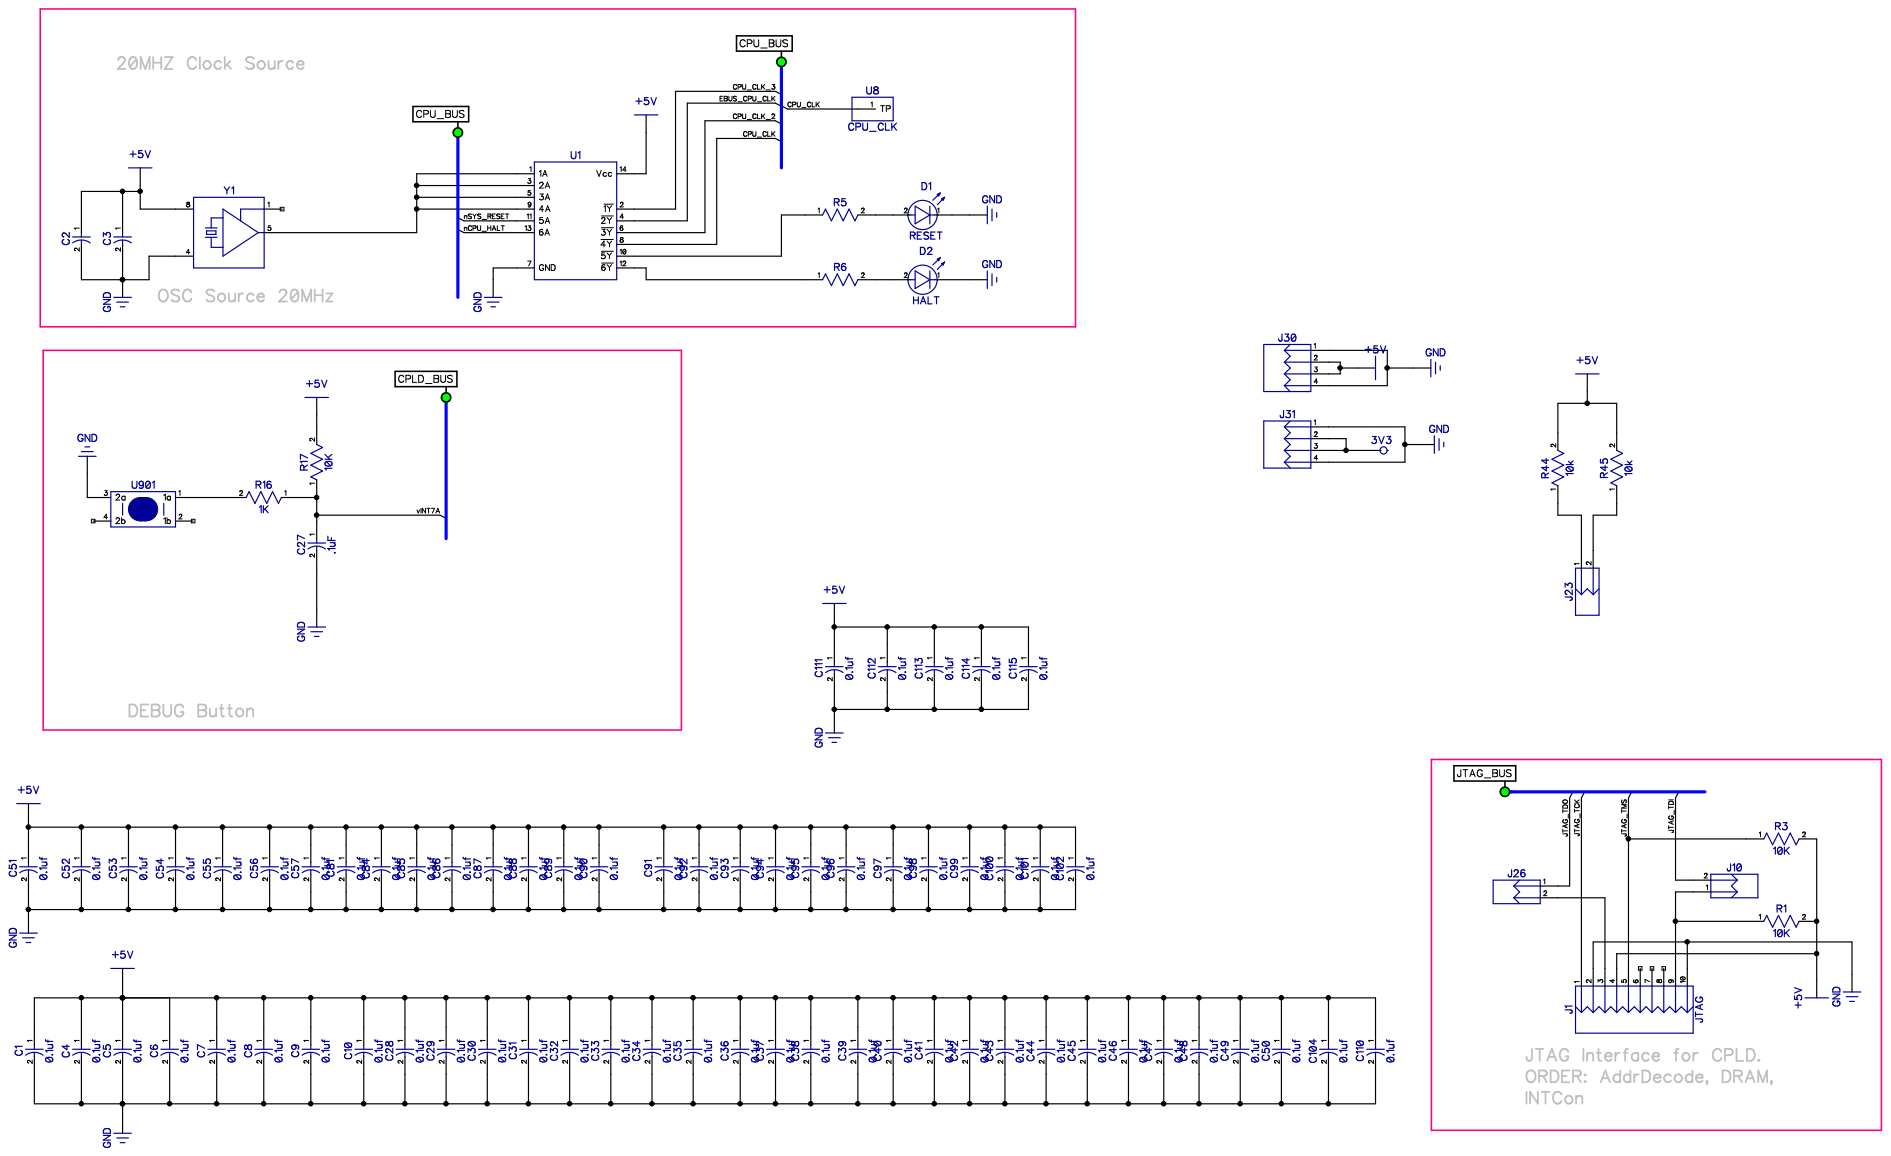
[picture p38: page 1]

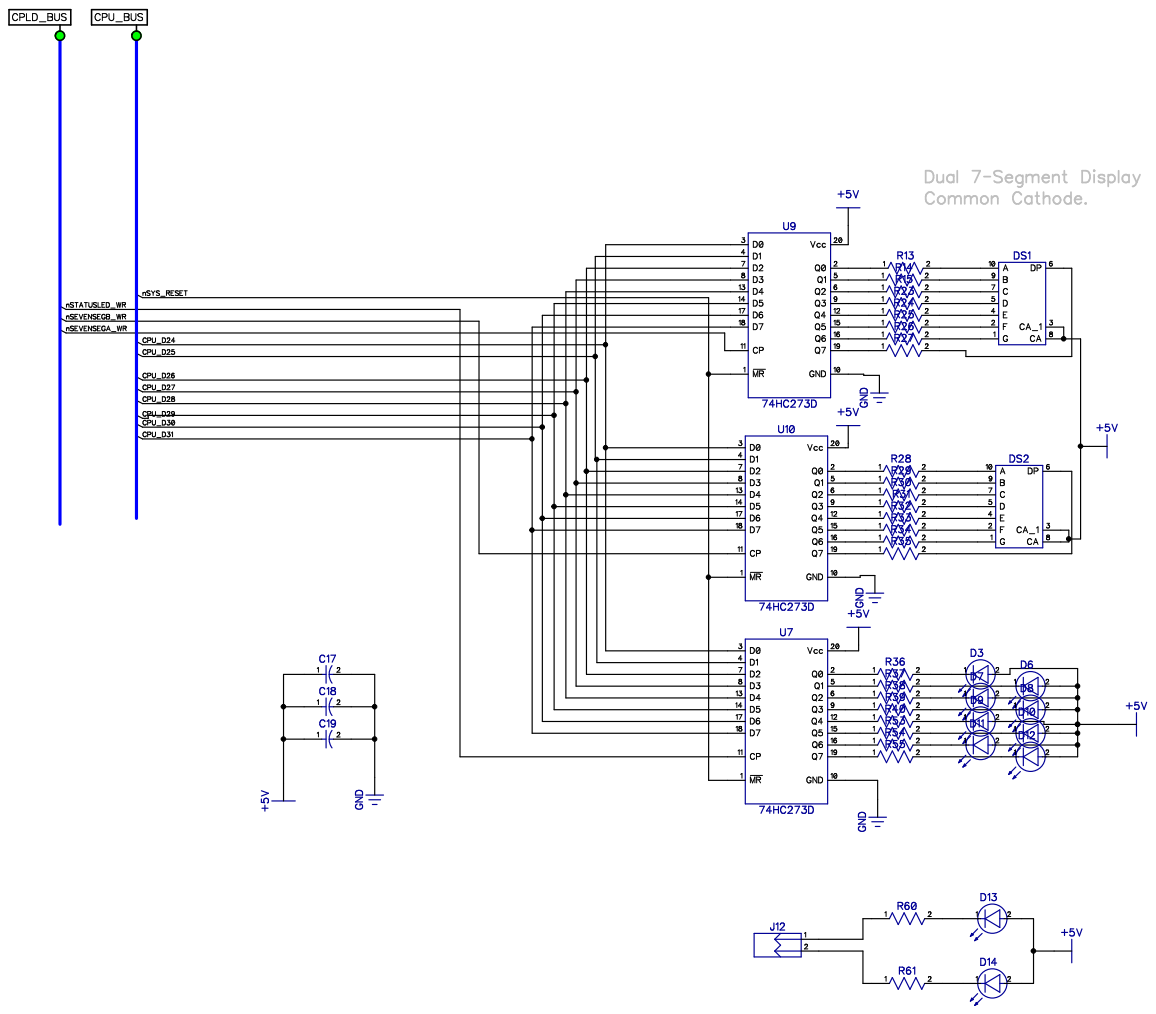
[picture p39: page 2]

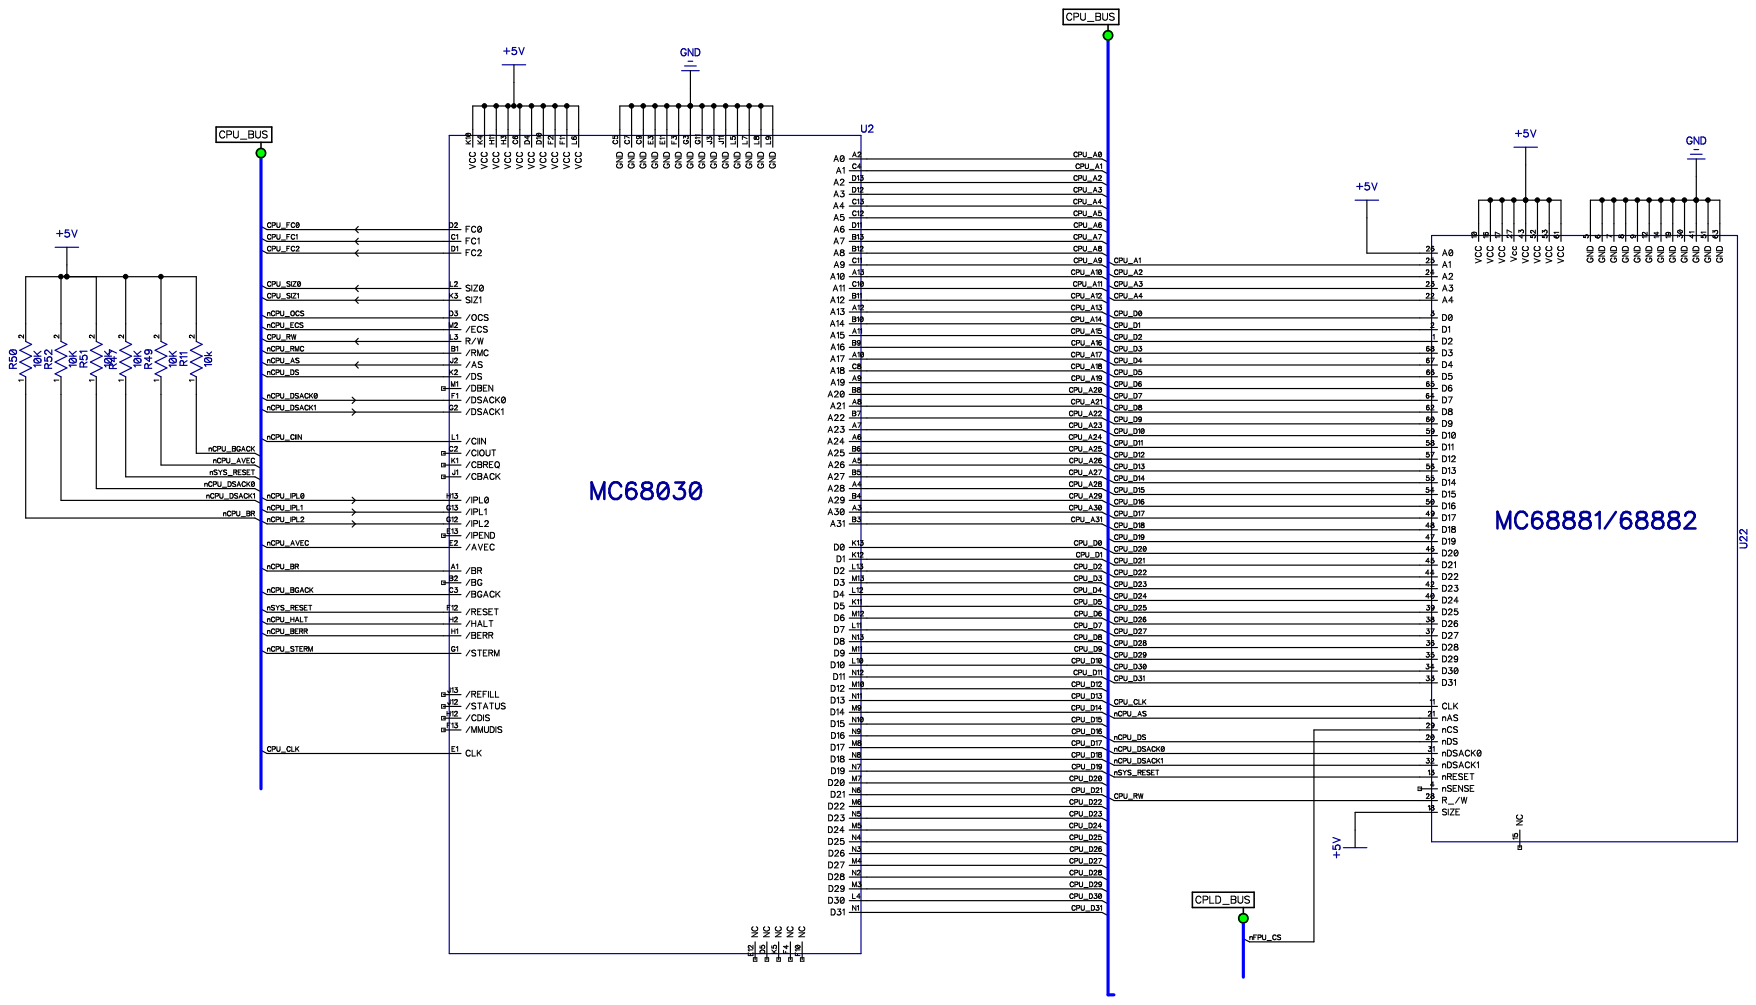
[picture p40: page 3]

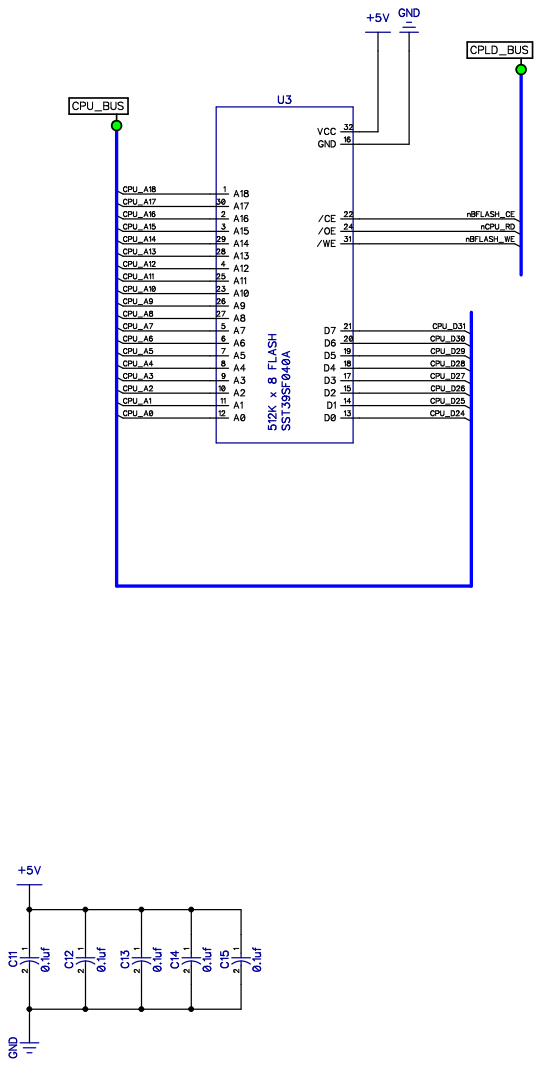
[picture p41: page 4]

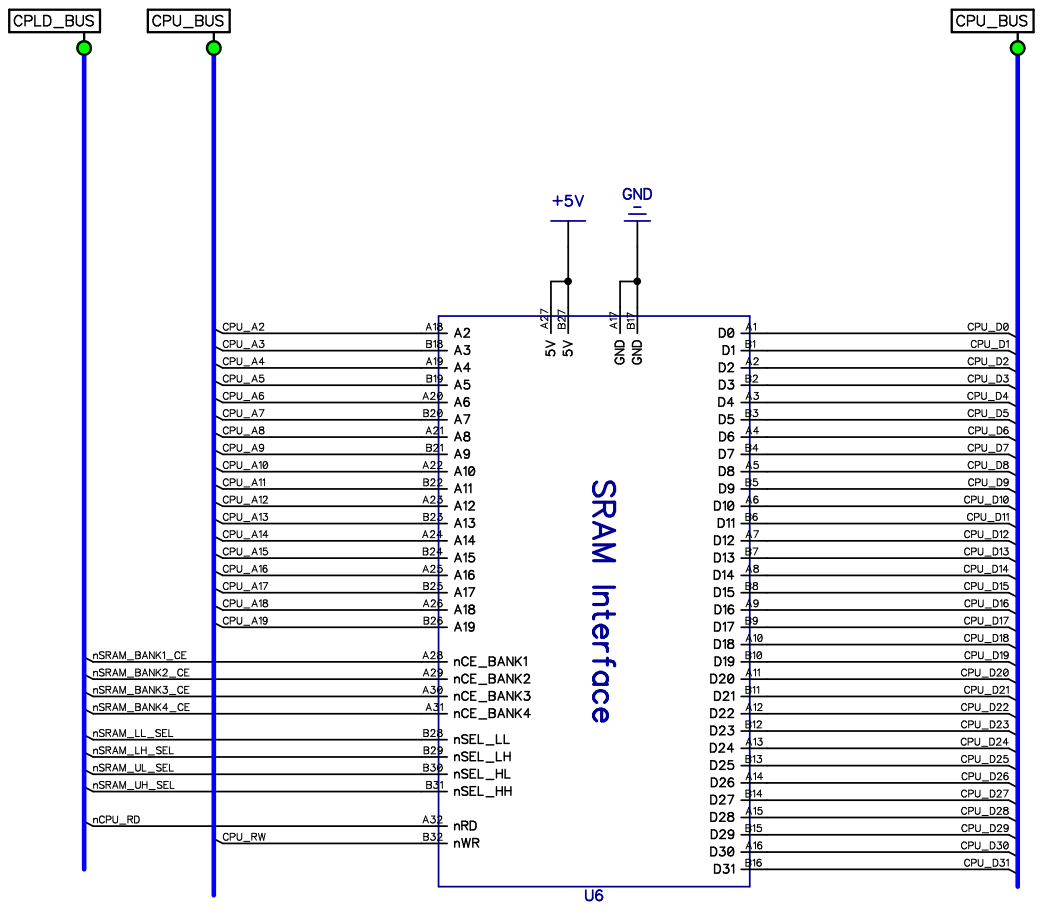
[picture p42: page 5]

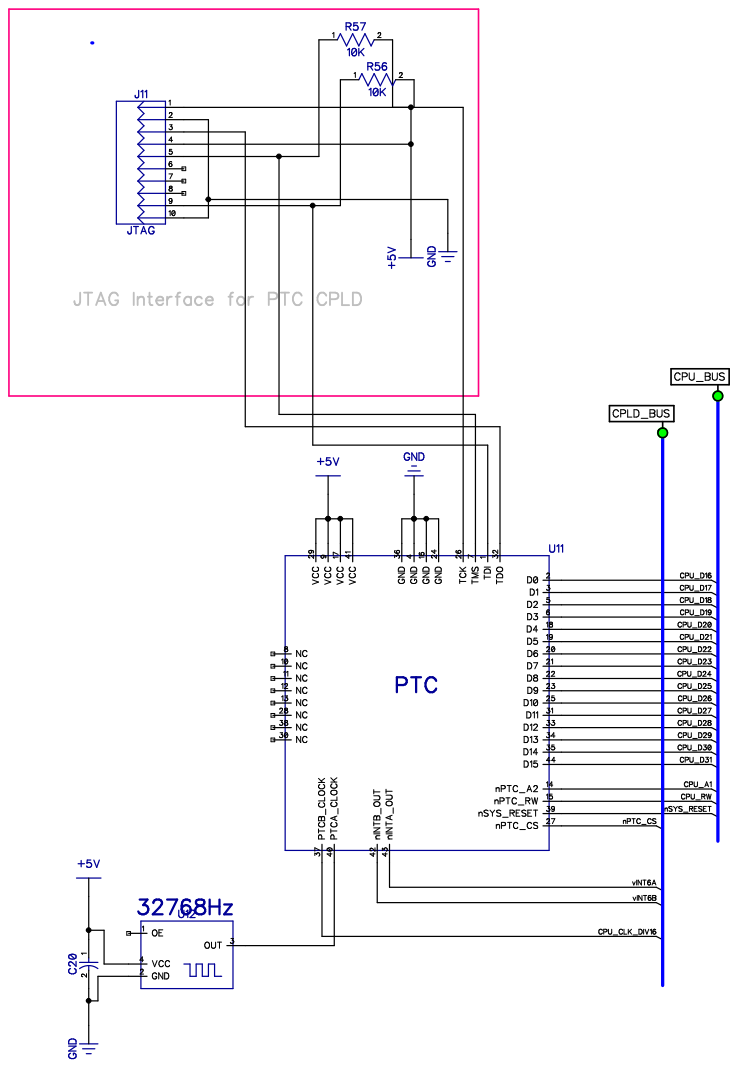
[picture p43: page 6]

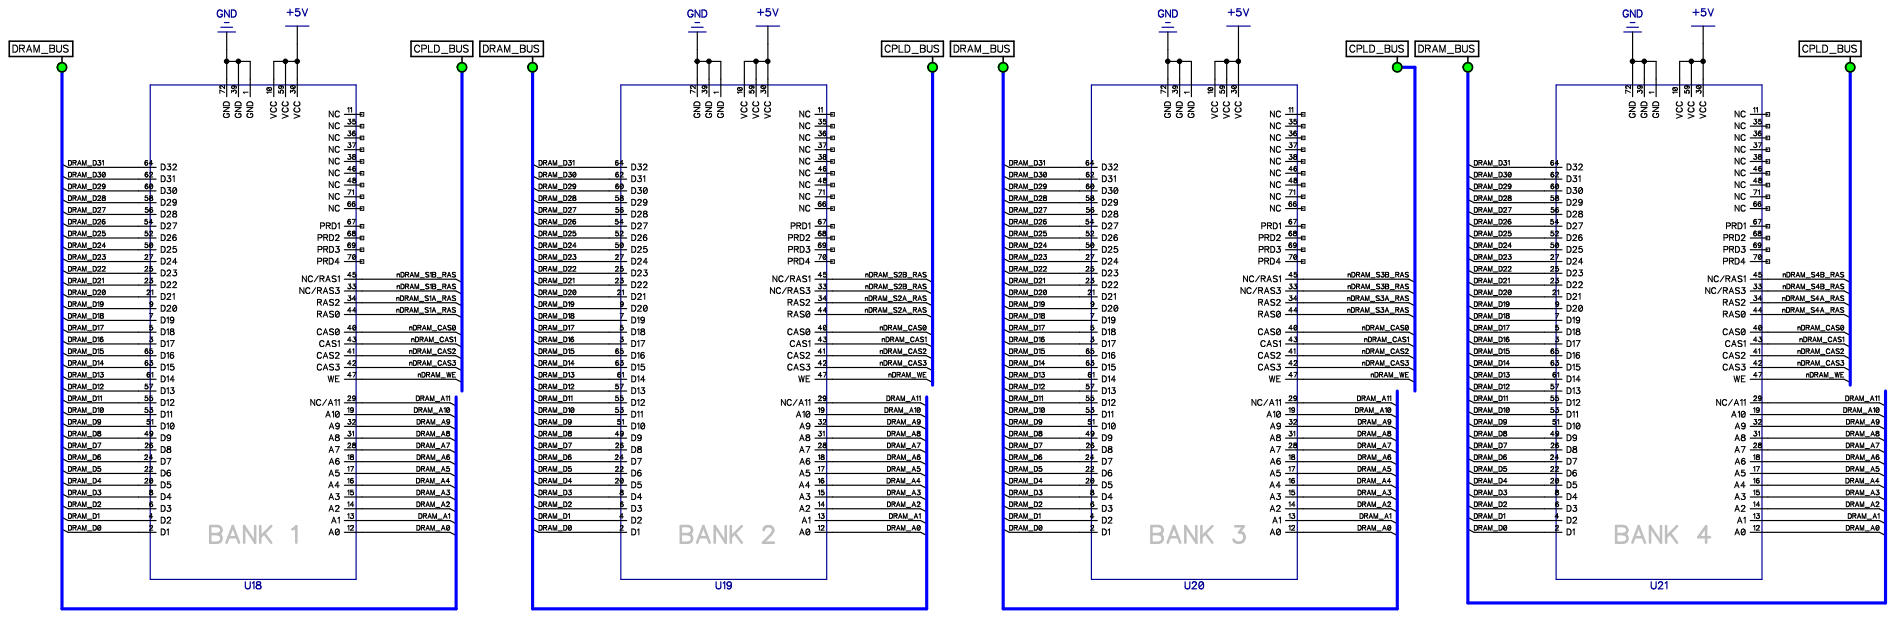
[picture p44: page 7]

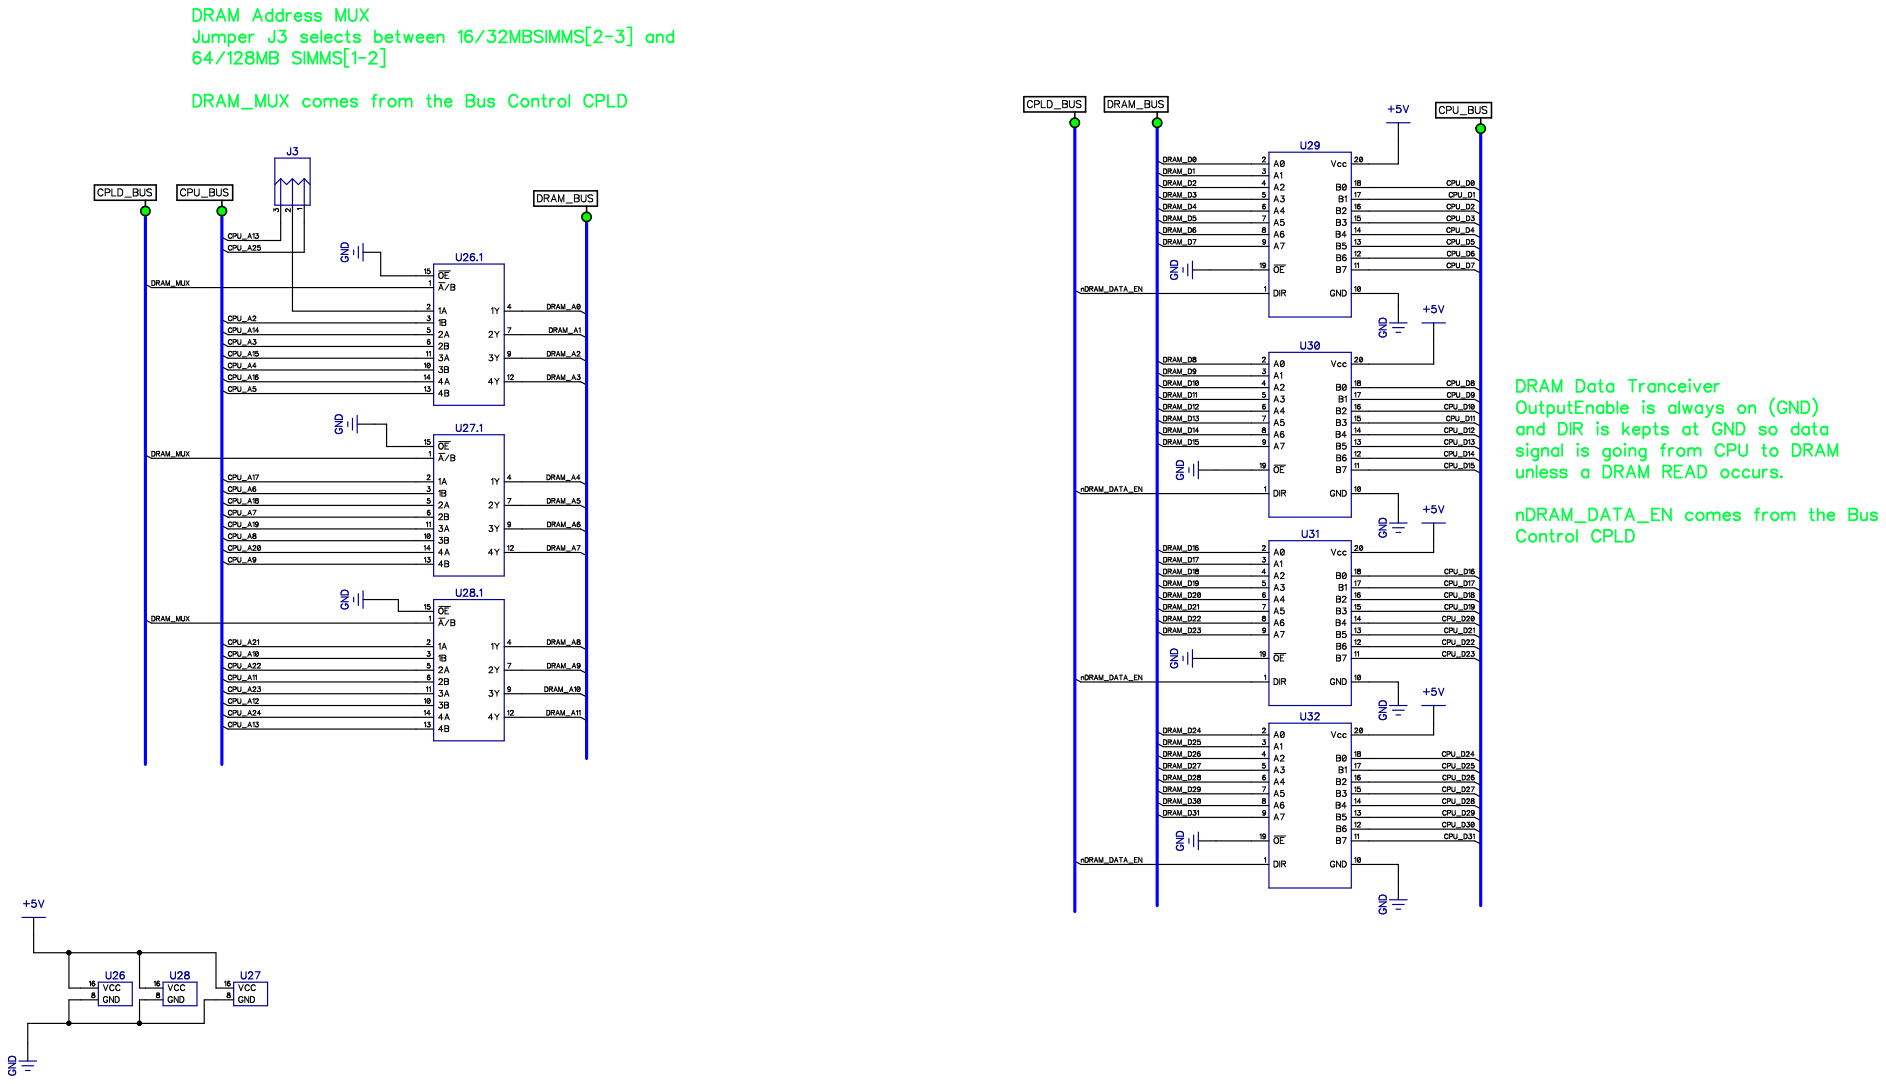
[picture p45: page 8]

GND GND

OutputEnable is always on

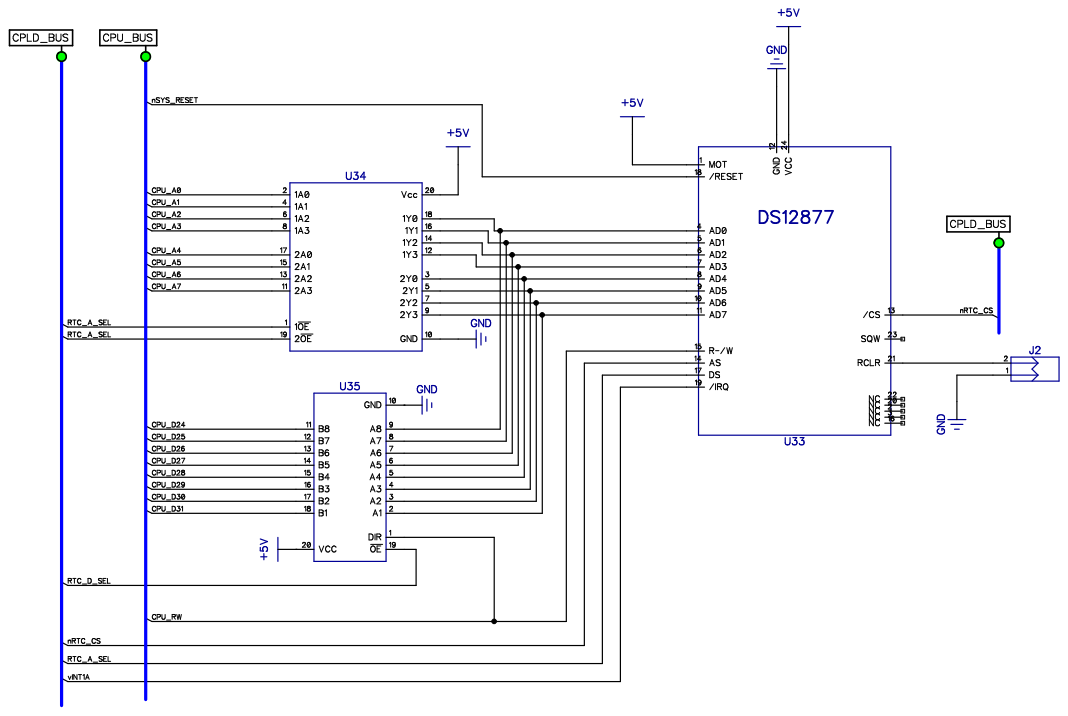
[picture p46: page 9]

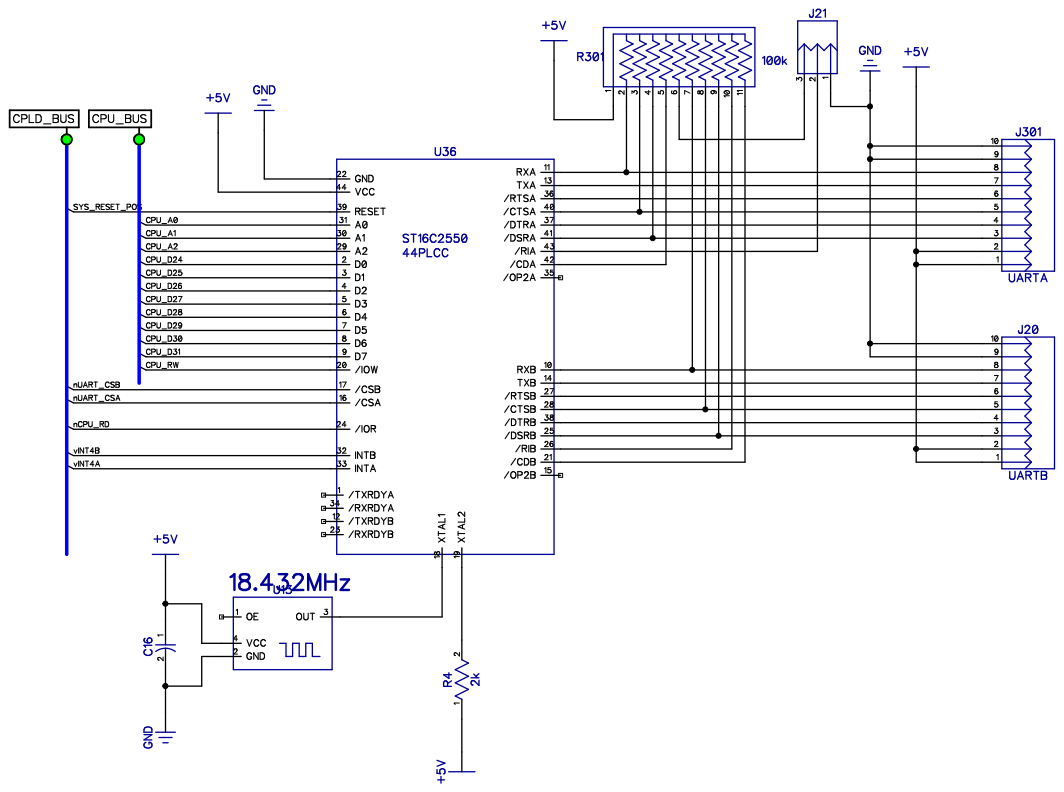
[picture p47: page 10]

44PLCCU36
/RTSA 36 /DTRA 37 /DTRB 38
/CTSA 40 /DSRA 41 /CDA 42 /RIA 43

RXB 10
TXB 14
/DSRB 25 /RIB 26 /RTSB 27 /CTSB 28

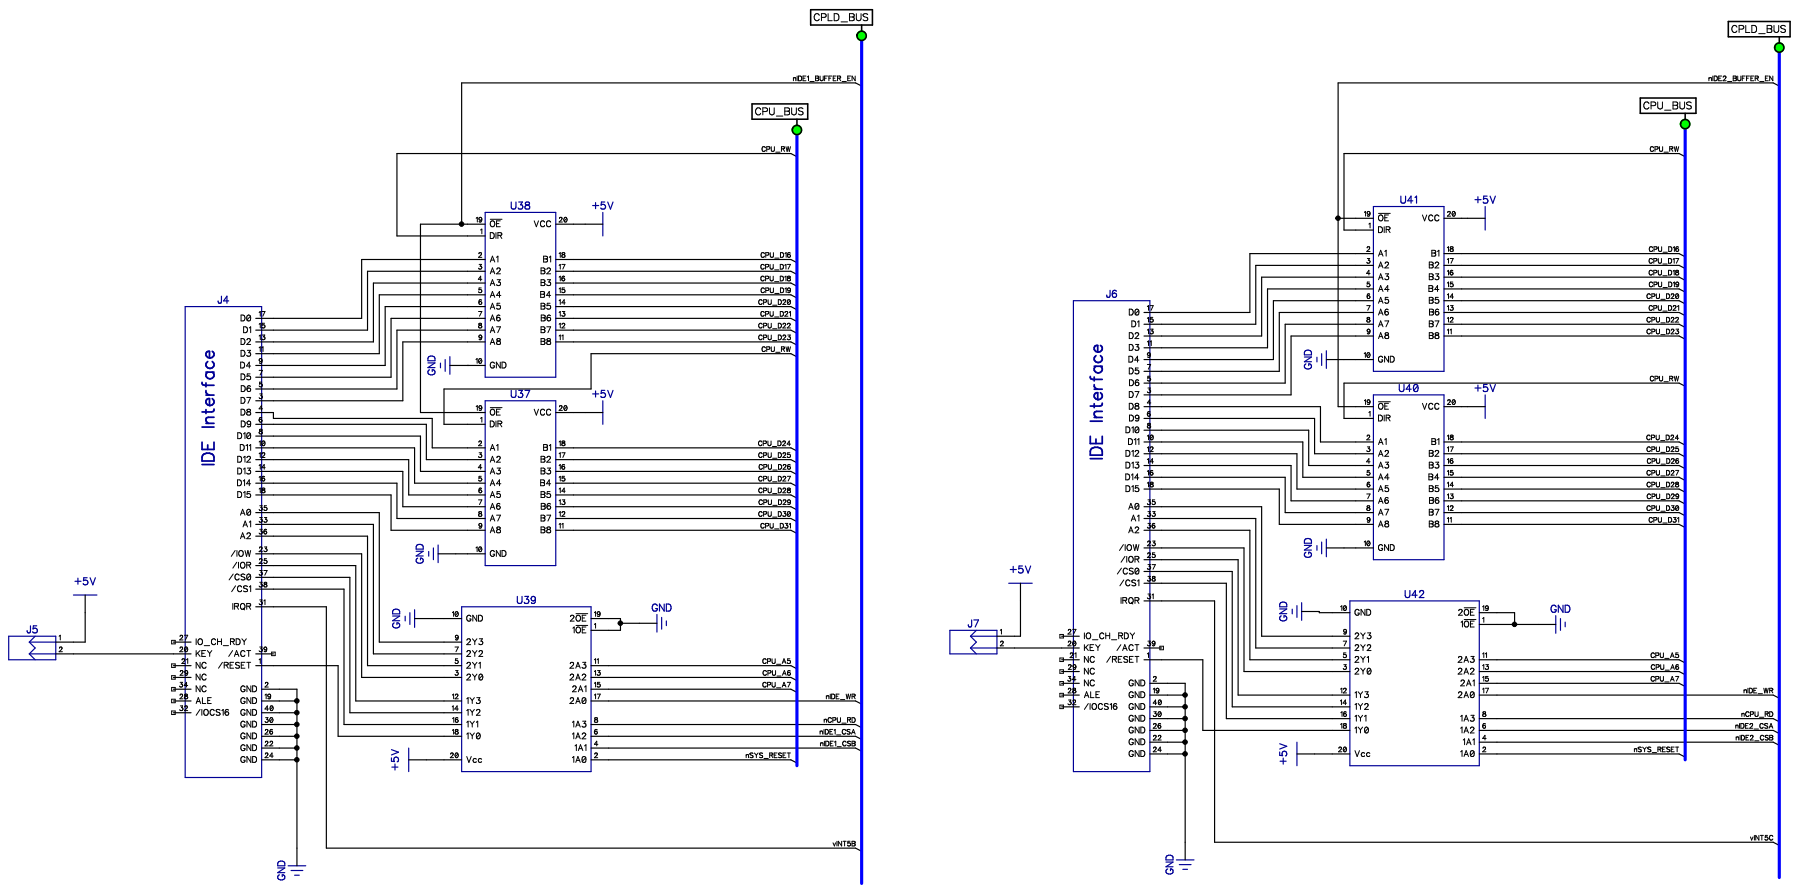
[picture p48: page 11]

_BUS

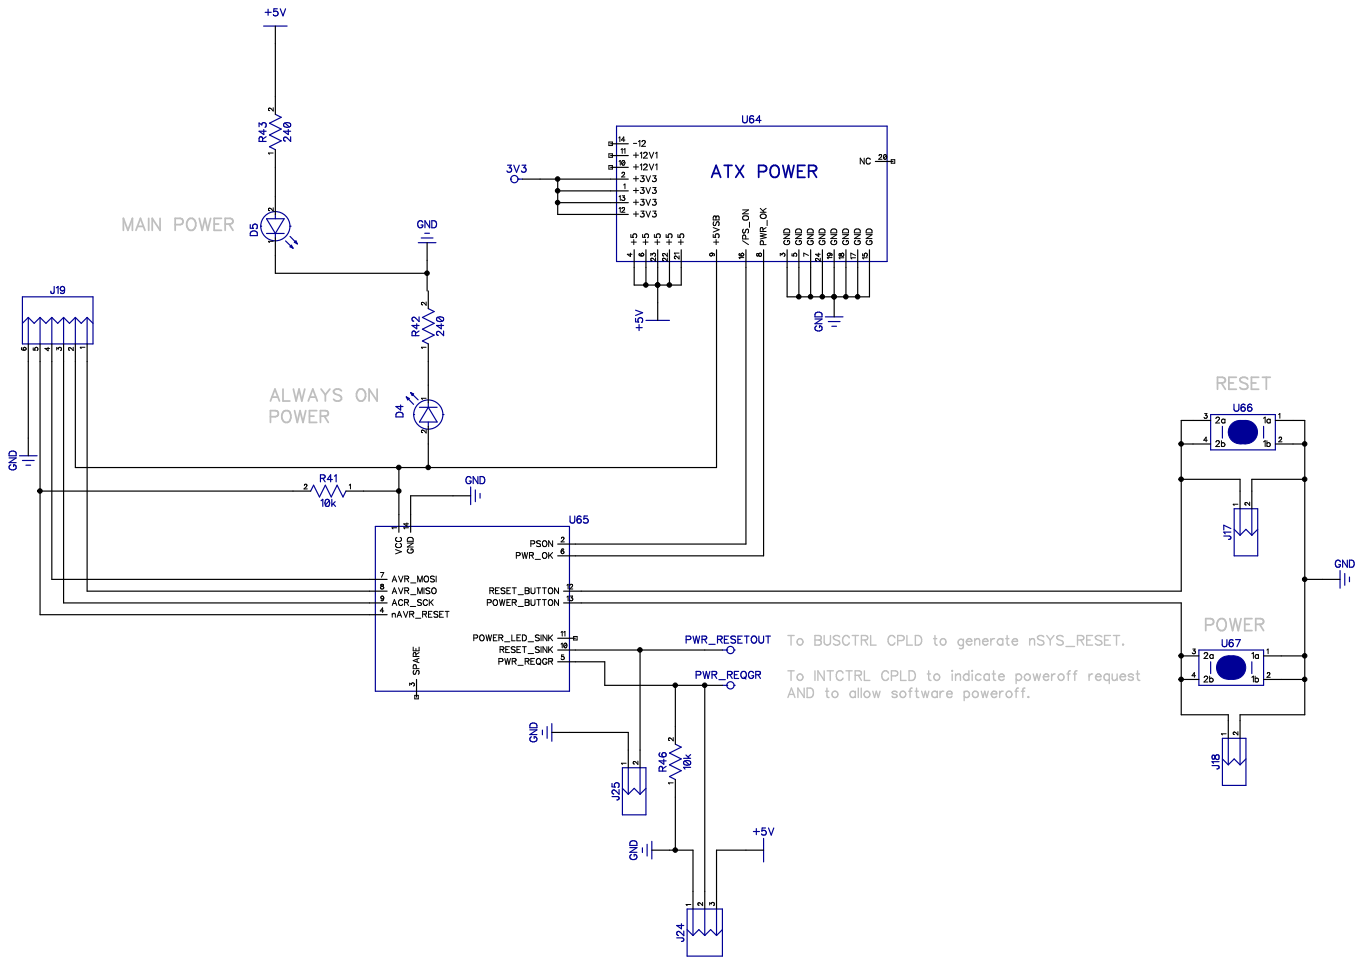
[picture p49: page 12]

2b | 1b

To BUSCTRL CPLD to generate nSYS_RESET.

To INTCTRL CPLD to indicate poweroff request

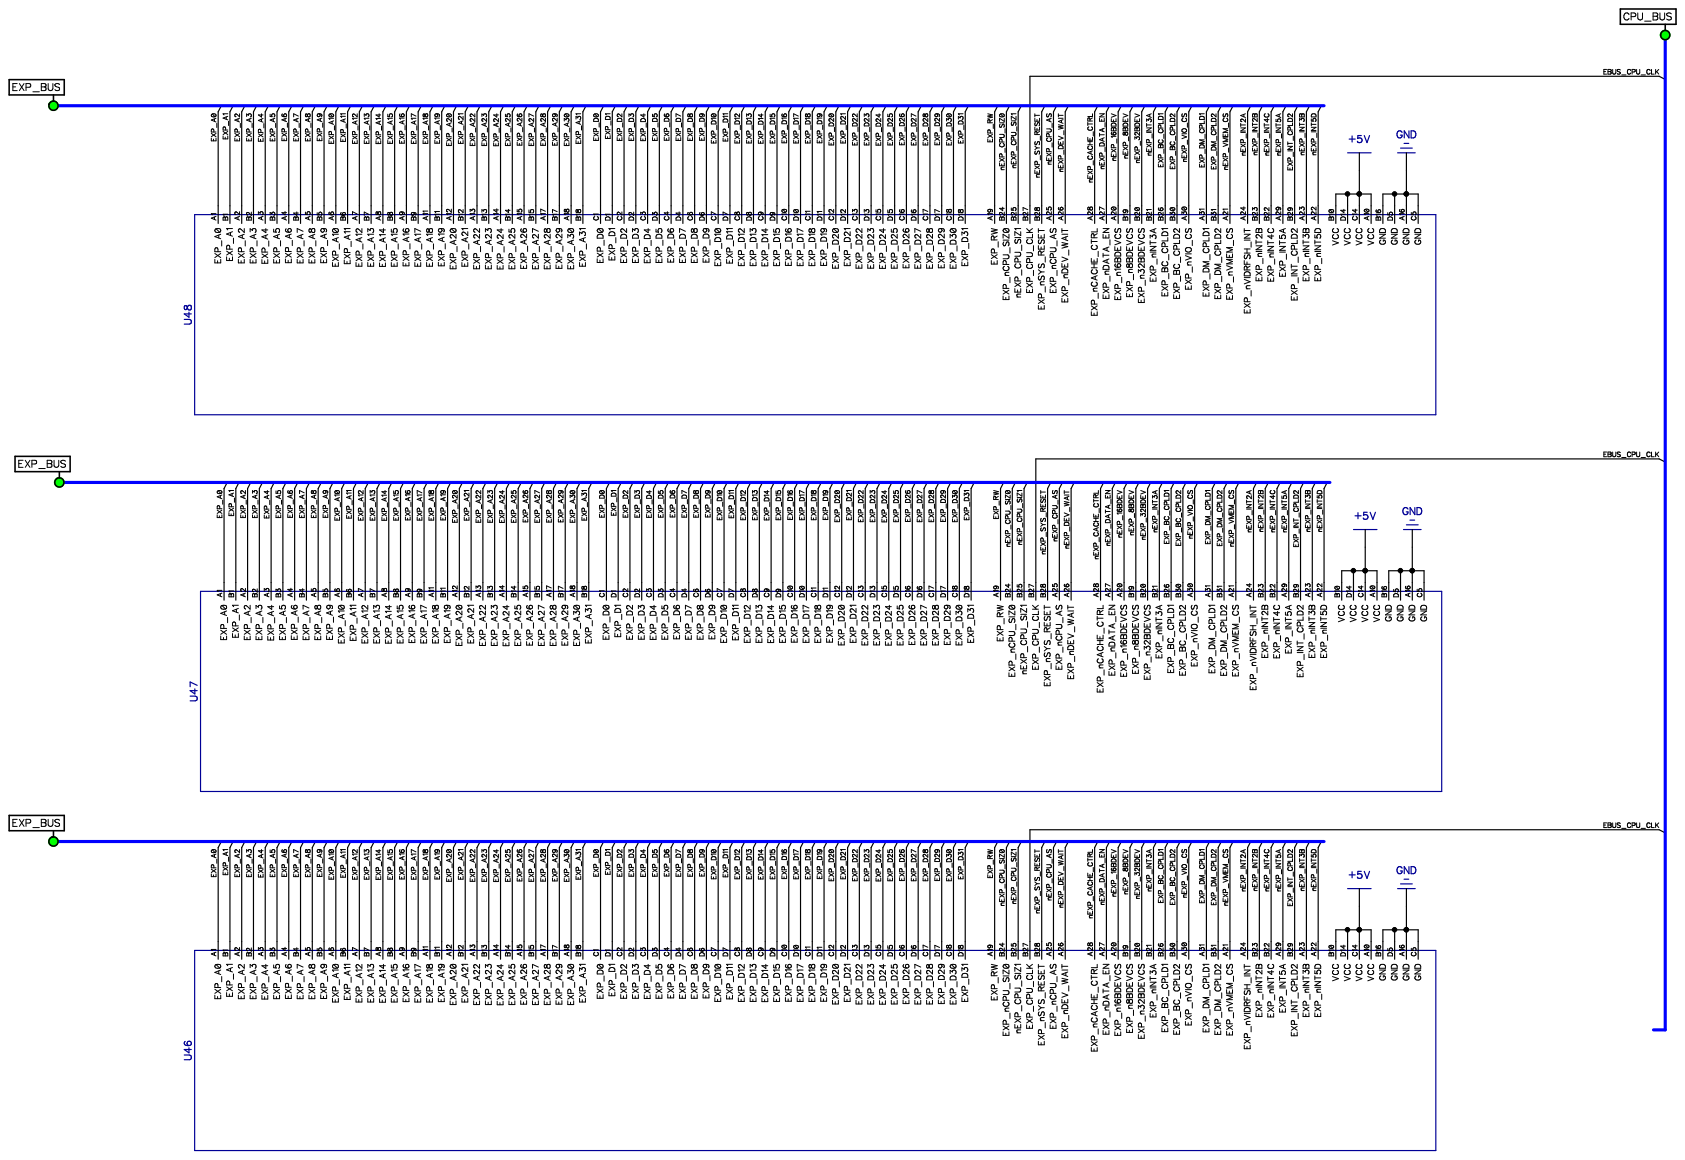
[picture p50: page 13]

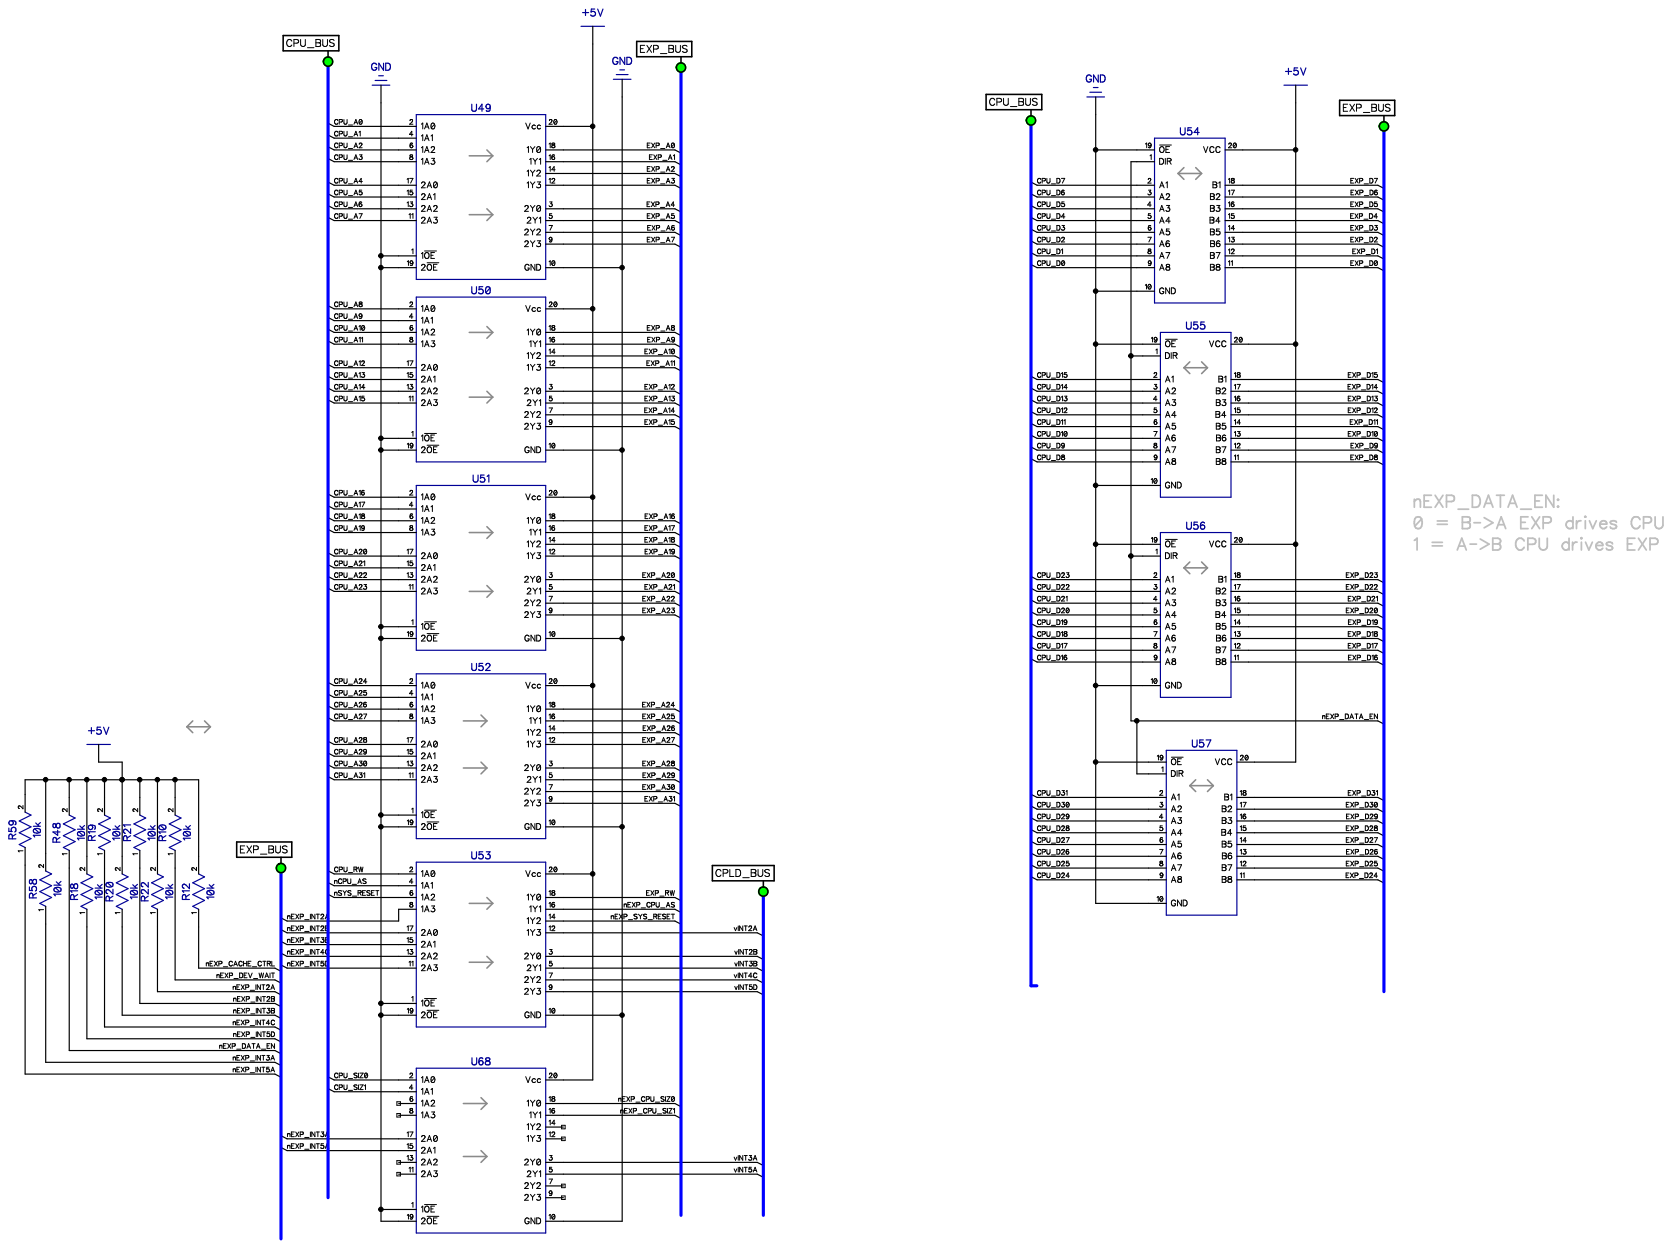
[picture p51: page 14]

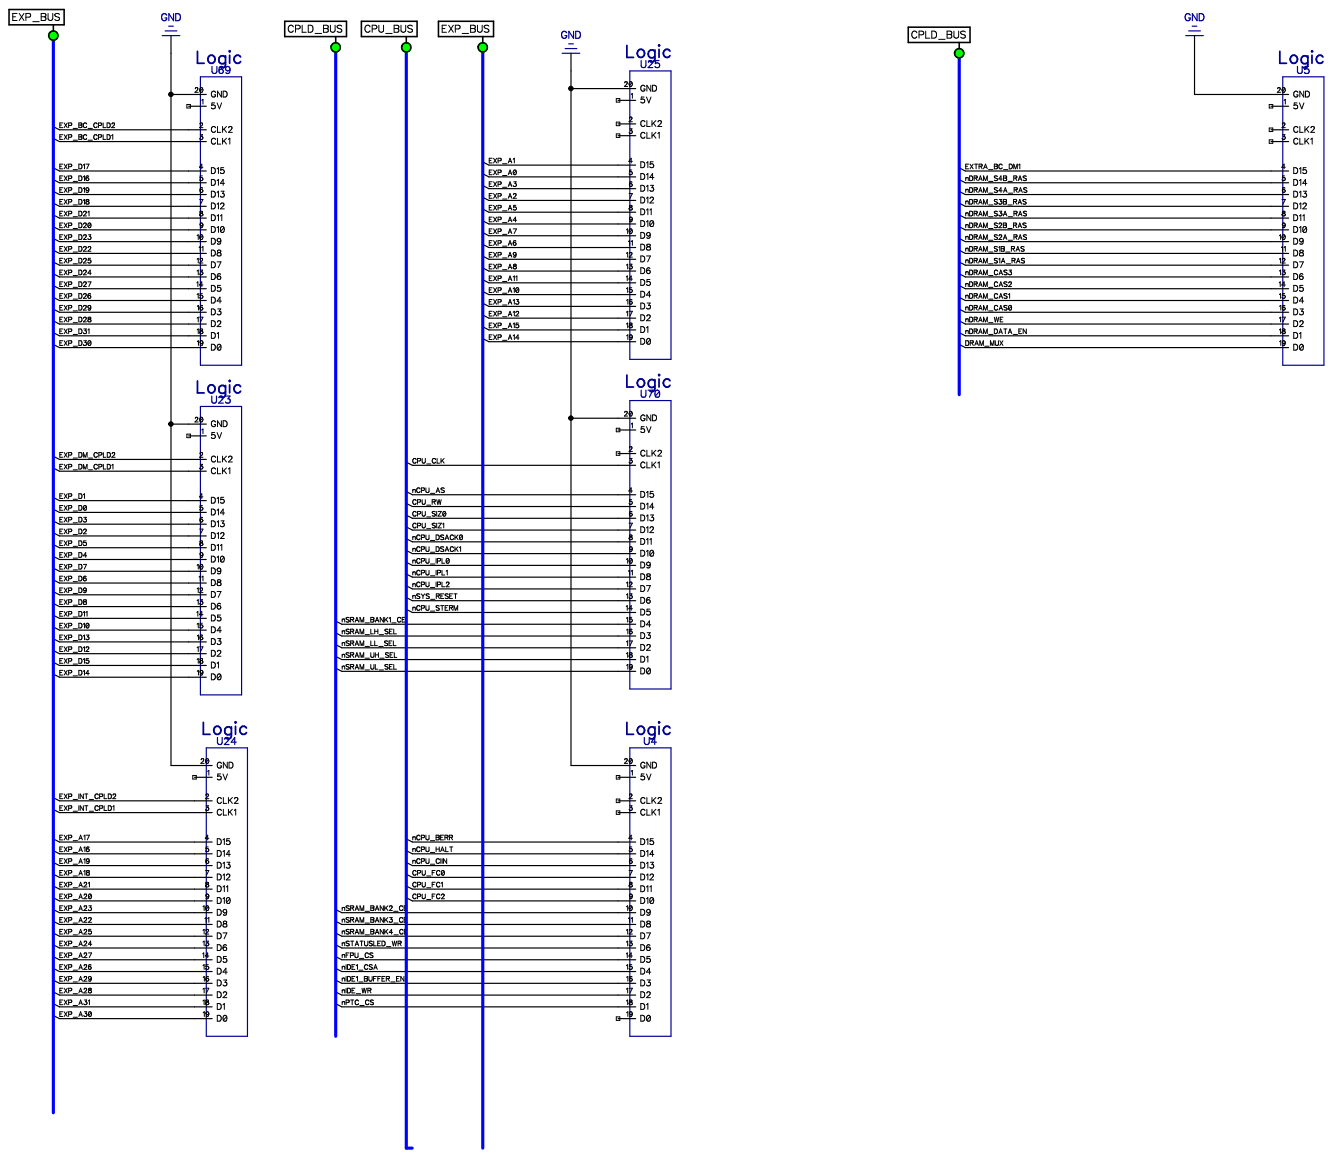
[picture p52: page 15]

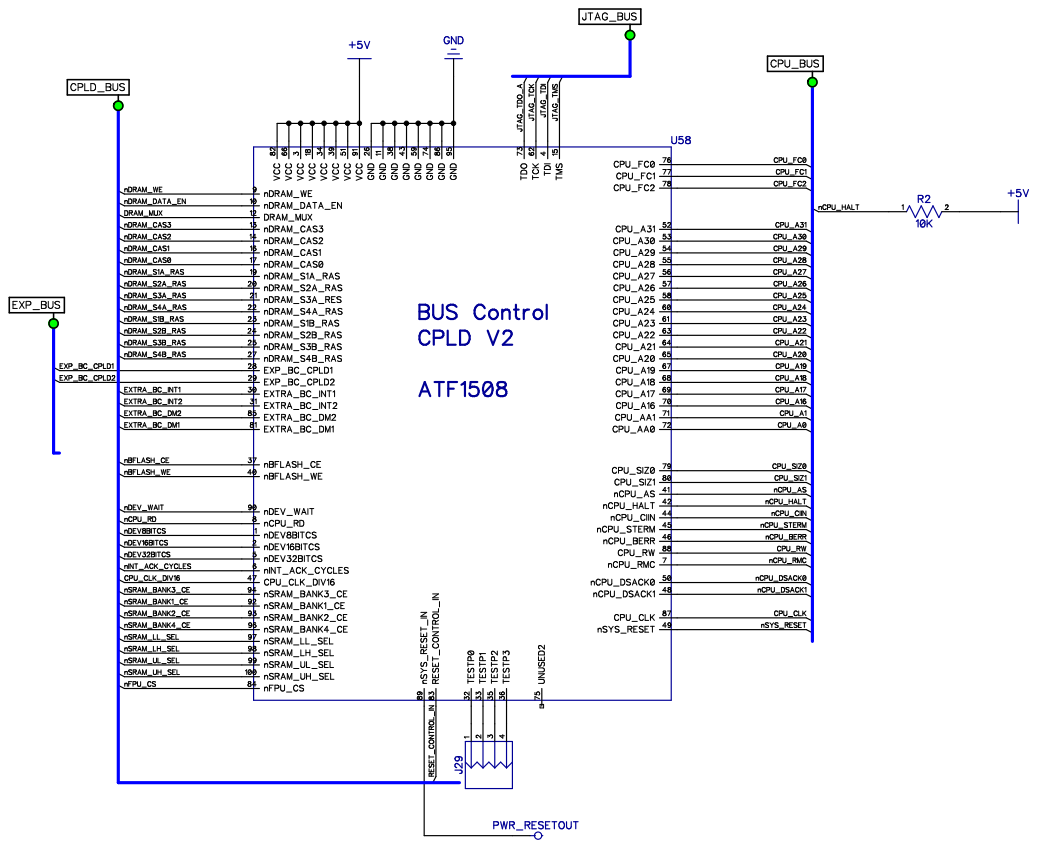
[picture p53: page 16]

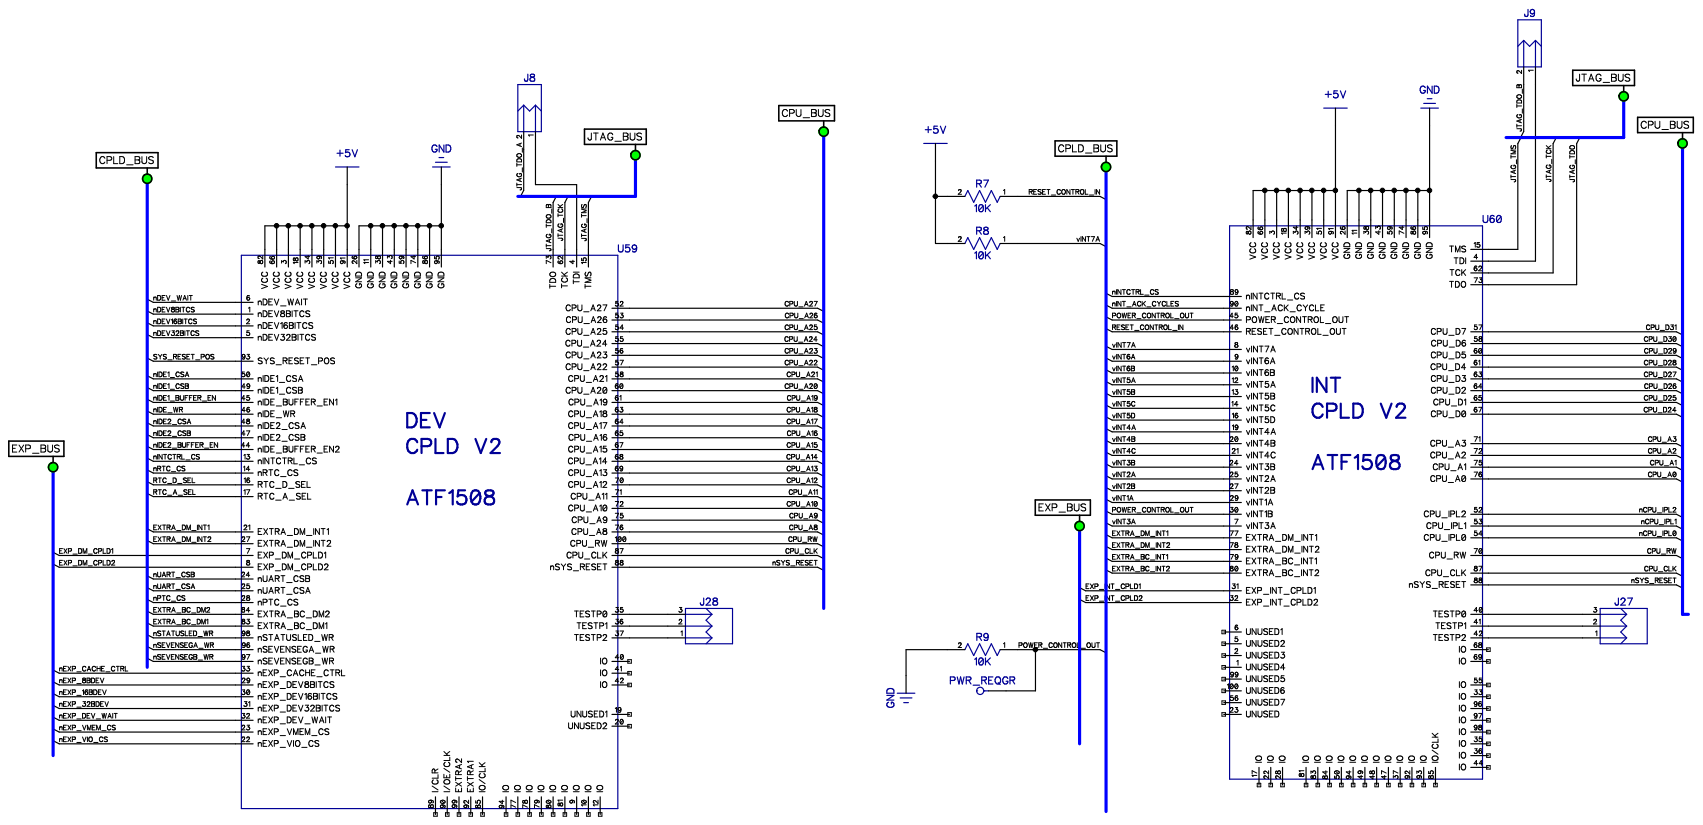
[picture p54: page 17]
