jeffsponaugle/roscoe/docs/InterruptVectors.pdf

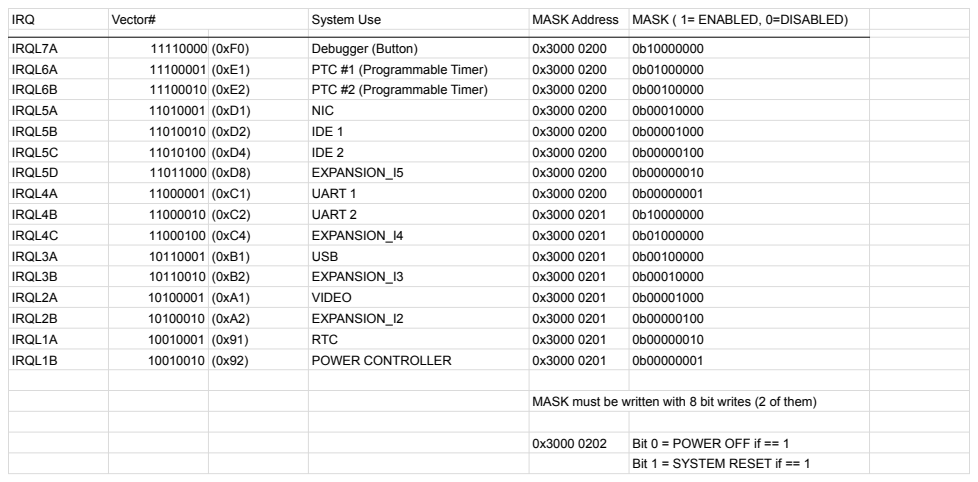
[picture p55: page 1]
IRQ; Vector#; System Use; MASK Address MASK ( 1= ENABLED, 0=DISABLED); IRQL7A; Debugger (Button); IRQL6A; PTC #1 (Programmable Timer); IRQL6B; PTC #2 (Programmable Timer); IRQL5A; NIC; IRQL5B; IDE 1; IRQL5C; IDE 2; IRQL5D; EXPANSION_I5; IRQL4A; UART 1; IRQL4B; UART 2; IRQL4C; EXPANSION_I4; IRQL3A; USB; IRQL3B; EXPANSION_I3; IRQL2A; VIDEO; IRQL2B; EXPANSION_I2; IRQL1A; RTC; IRQL1B; POWER CONTROLLER; Bit 0 = POWER OFF if == 1

MASK must be written with 8 bit writes (2 of them)

Bit 1 = SYSTEM RESET if == 1
