jeffsponaugle/roscoe/docs/RoscoeSysDia.drawio.pdf

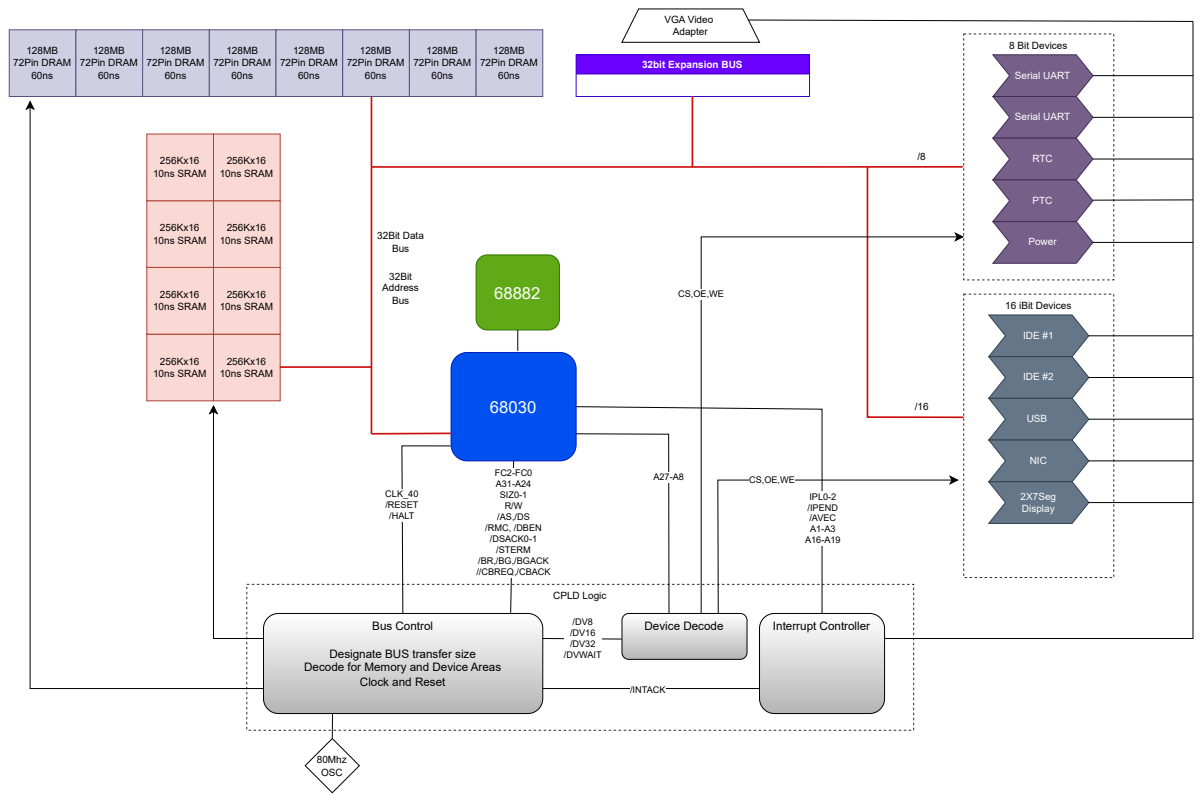
[picture p56: page 1]
16 iBit Devices; 8 Bit Devices; CPLD Logic; Bus Control; 32Bit Data Bus; 32Bit Address Bus; 128MB 72Pin DRAM 60ns; 80Mhz OSC; CLK_40 /RESET /HALT; 32bit Expansion BUS; Device Decode; Serial UART; RTC; PTC; Interrupt Controller; IDE #1; IDE #2; USB; NIC; VGA Video Adapter; 2X7Seg Display; /DV8 /DV16 /DV32 /DVWAIT; IPL0-2 /IPEND /AVEC A1-A3 A16-A19; /INTACK; Power

256Kx16 10ns SRAM | 256Kx16 10ns SRAM

FC2-FC0 A31-A24 SIZ0-1 R/W /AS,/DS /RMC, /DBEN /DSACK0-1 /STERM /BR,/BG,/BGACK //CBREQ,/CBACK

Designate BUS transfer size
Decode for Memory and Device Areas

Clock and Reset
