jeffsponaugle/roscoe/schematic/V2PCBBottom.pdf

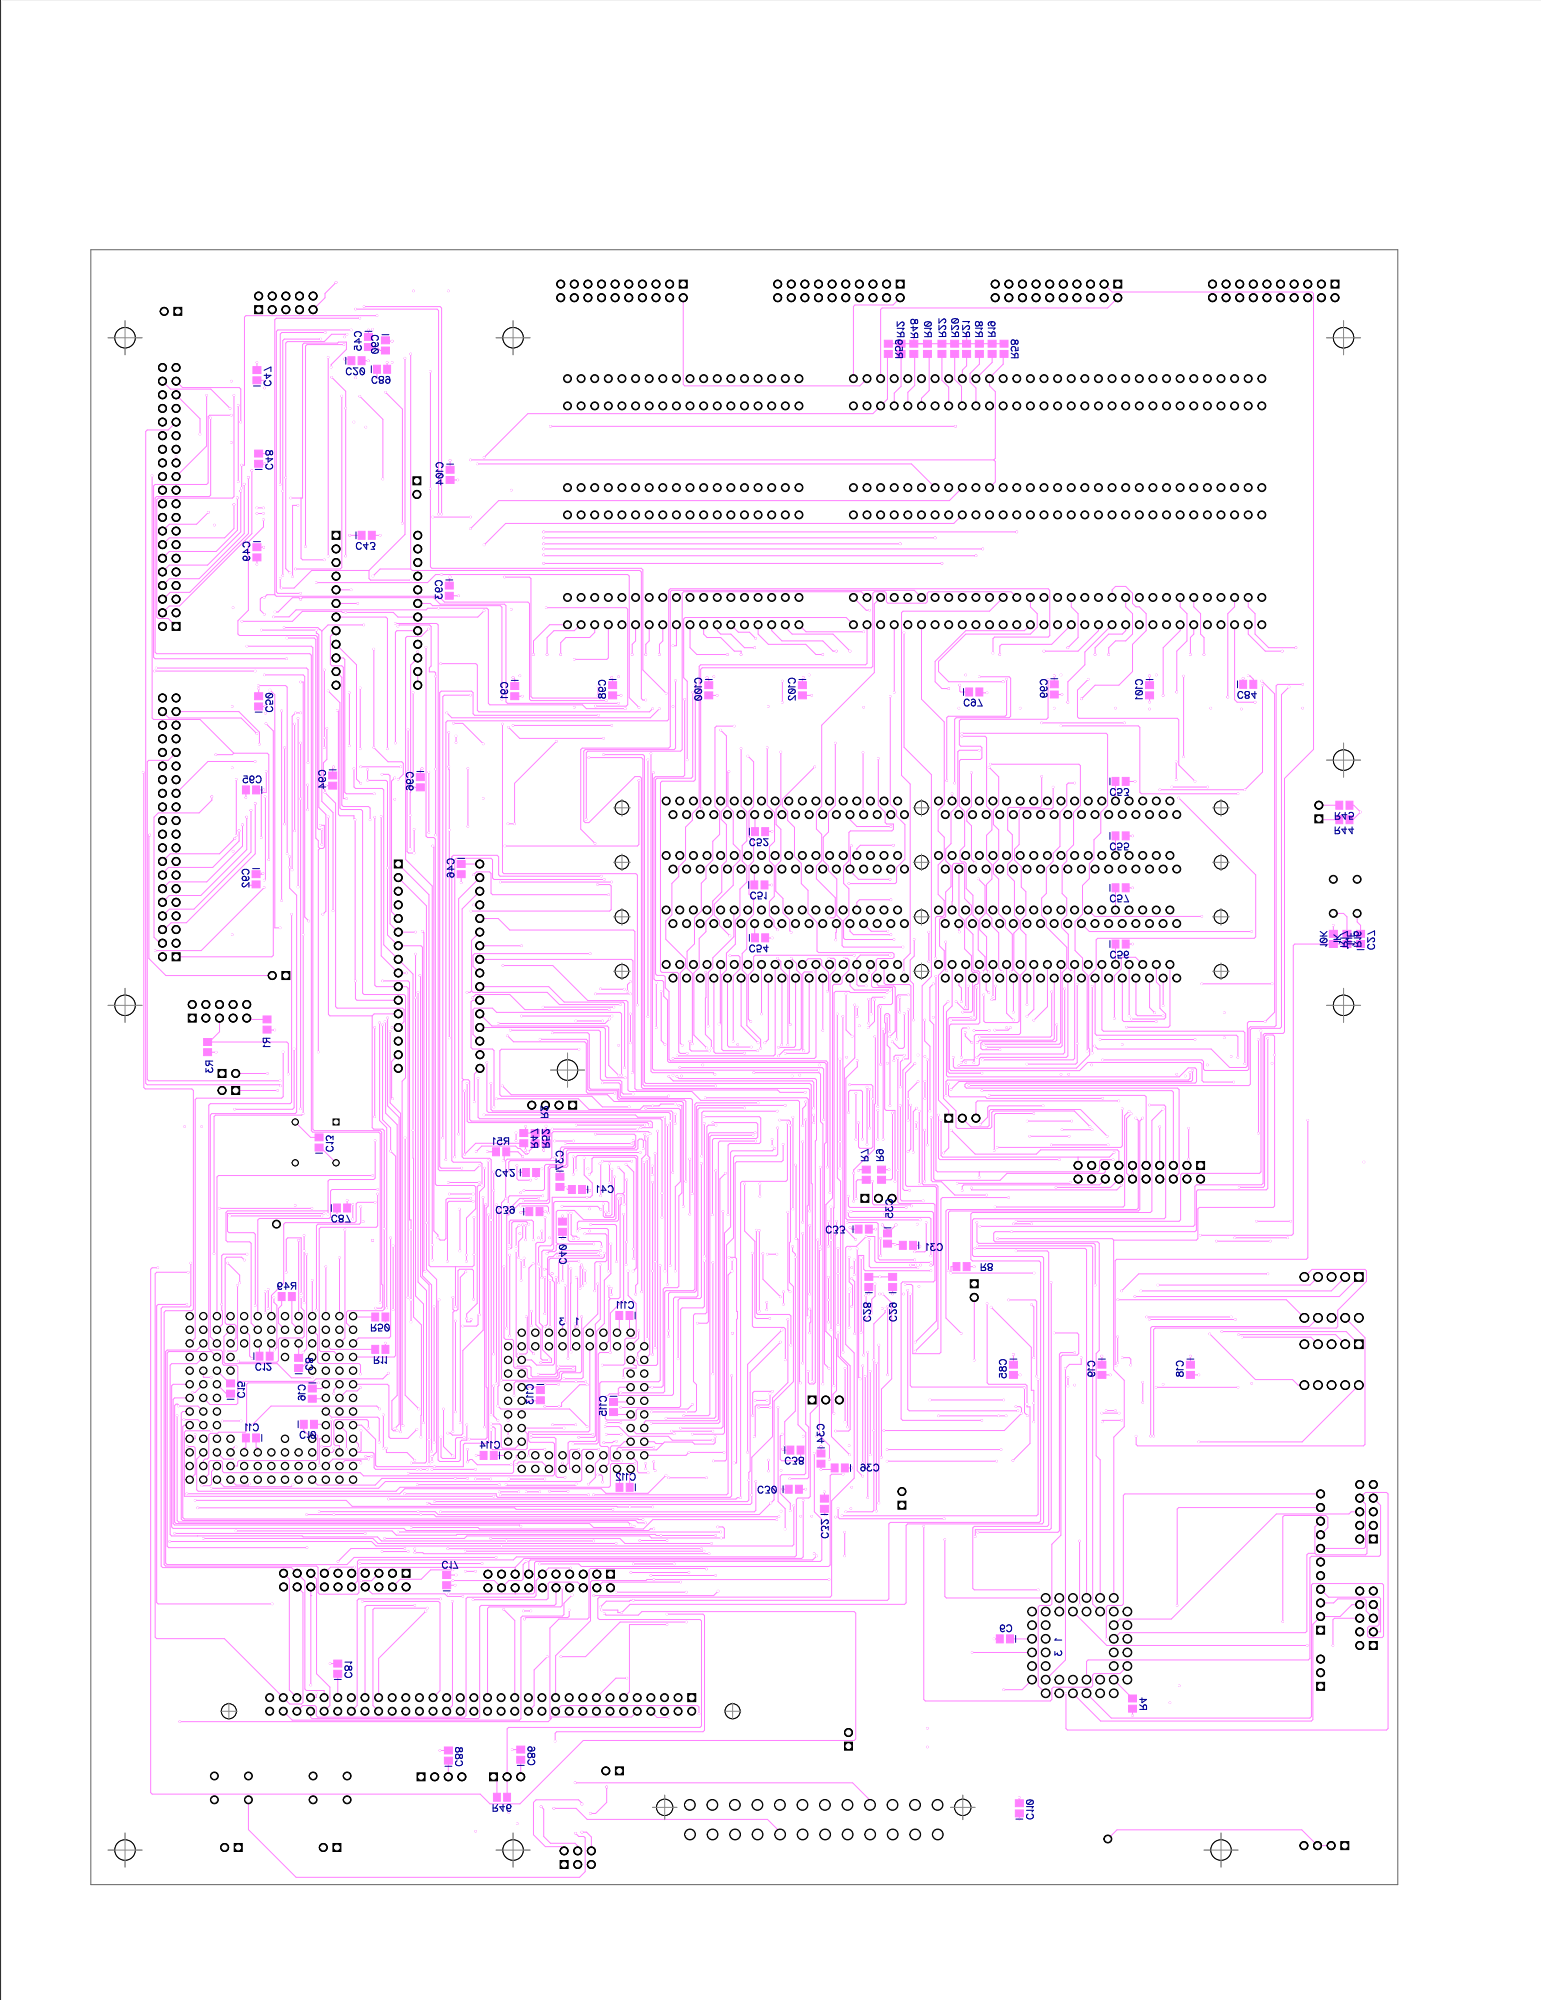
[picture p57: page 1]
