jeffsponaugle/roscoe/schematic/VGA/AD7123Carrier.pdf

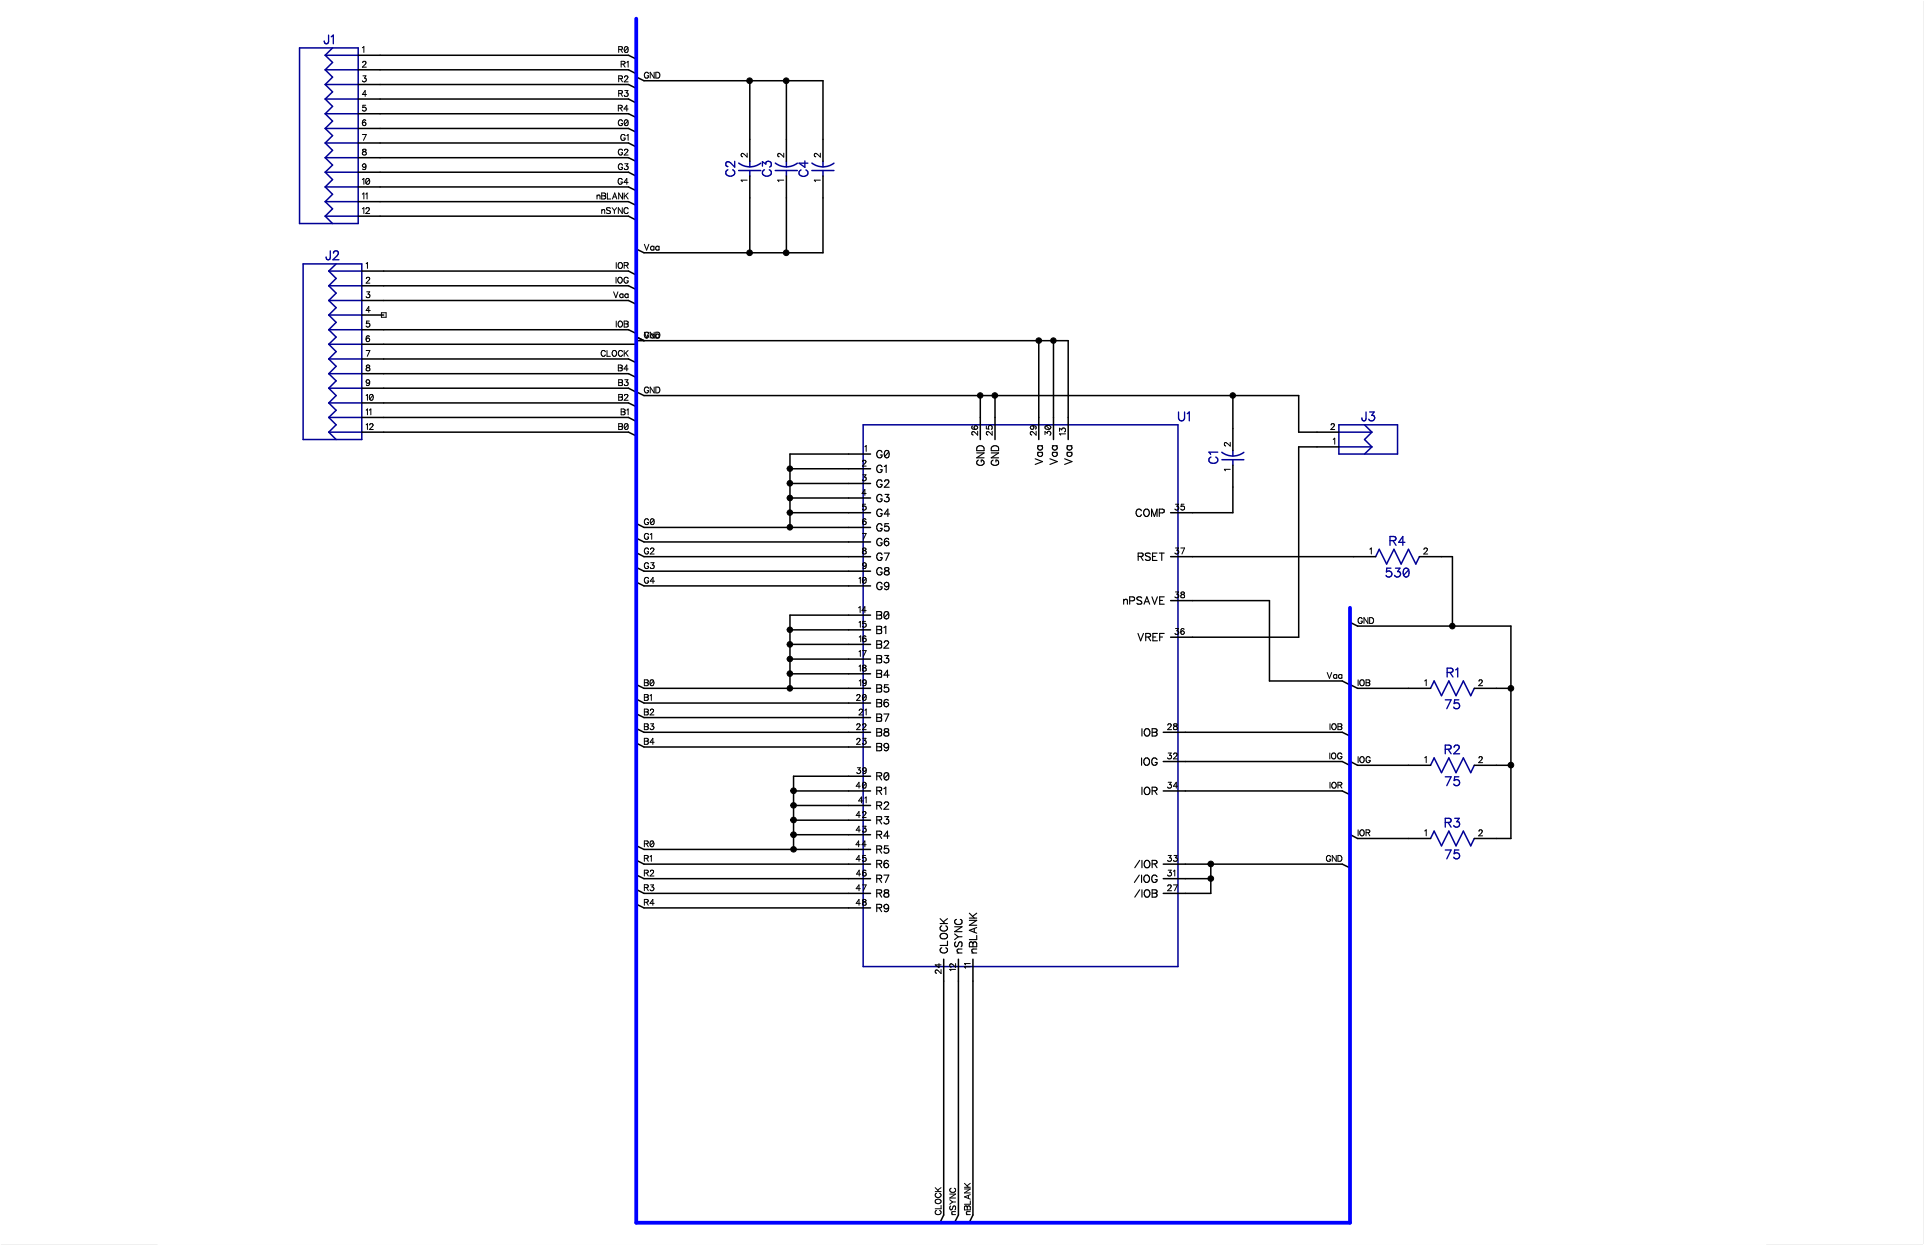
[picture p62: page 1]
