jeffsponaugle/roscoe/V2/RoscoeSRAMboardV2.pdf

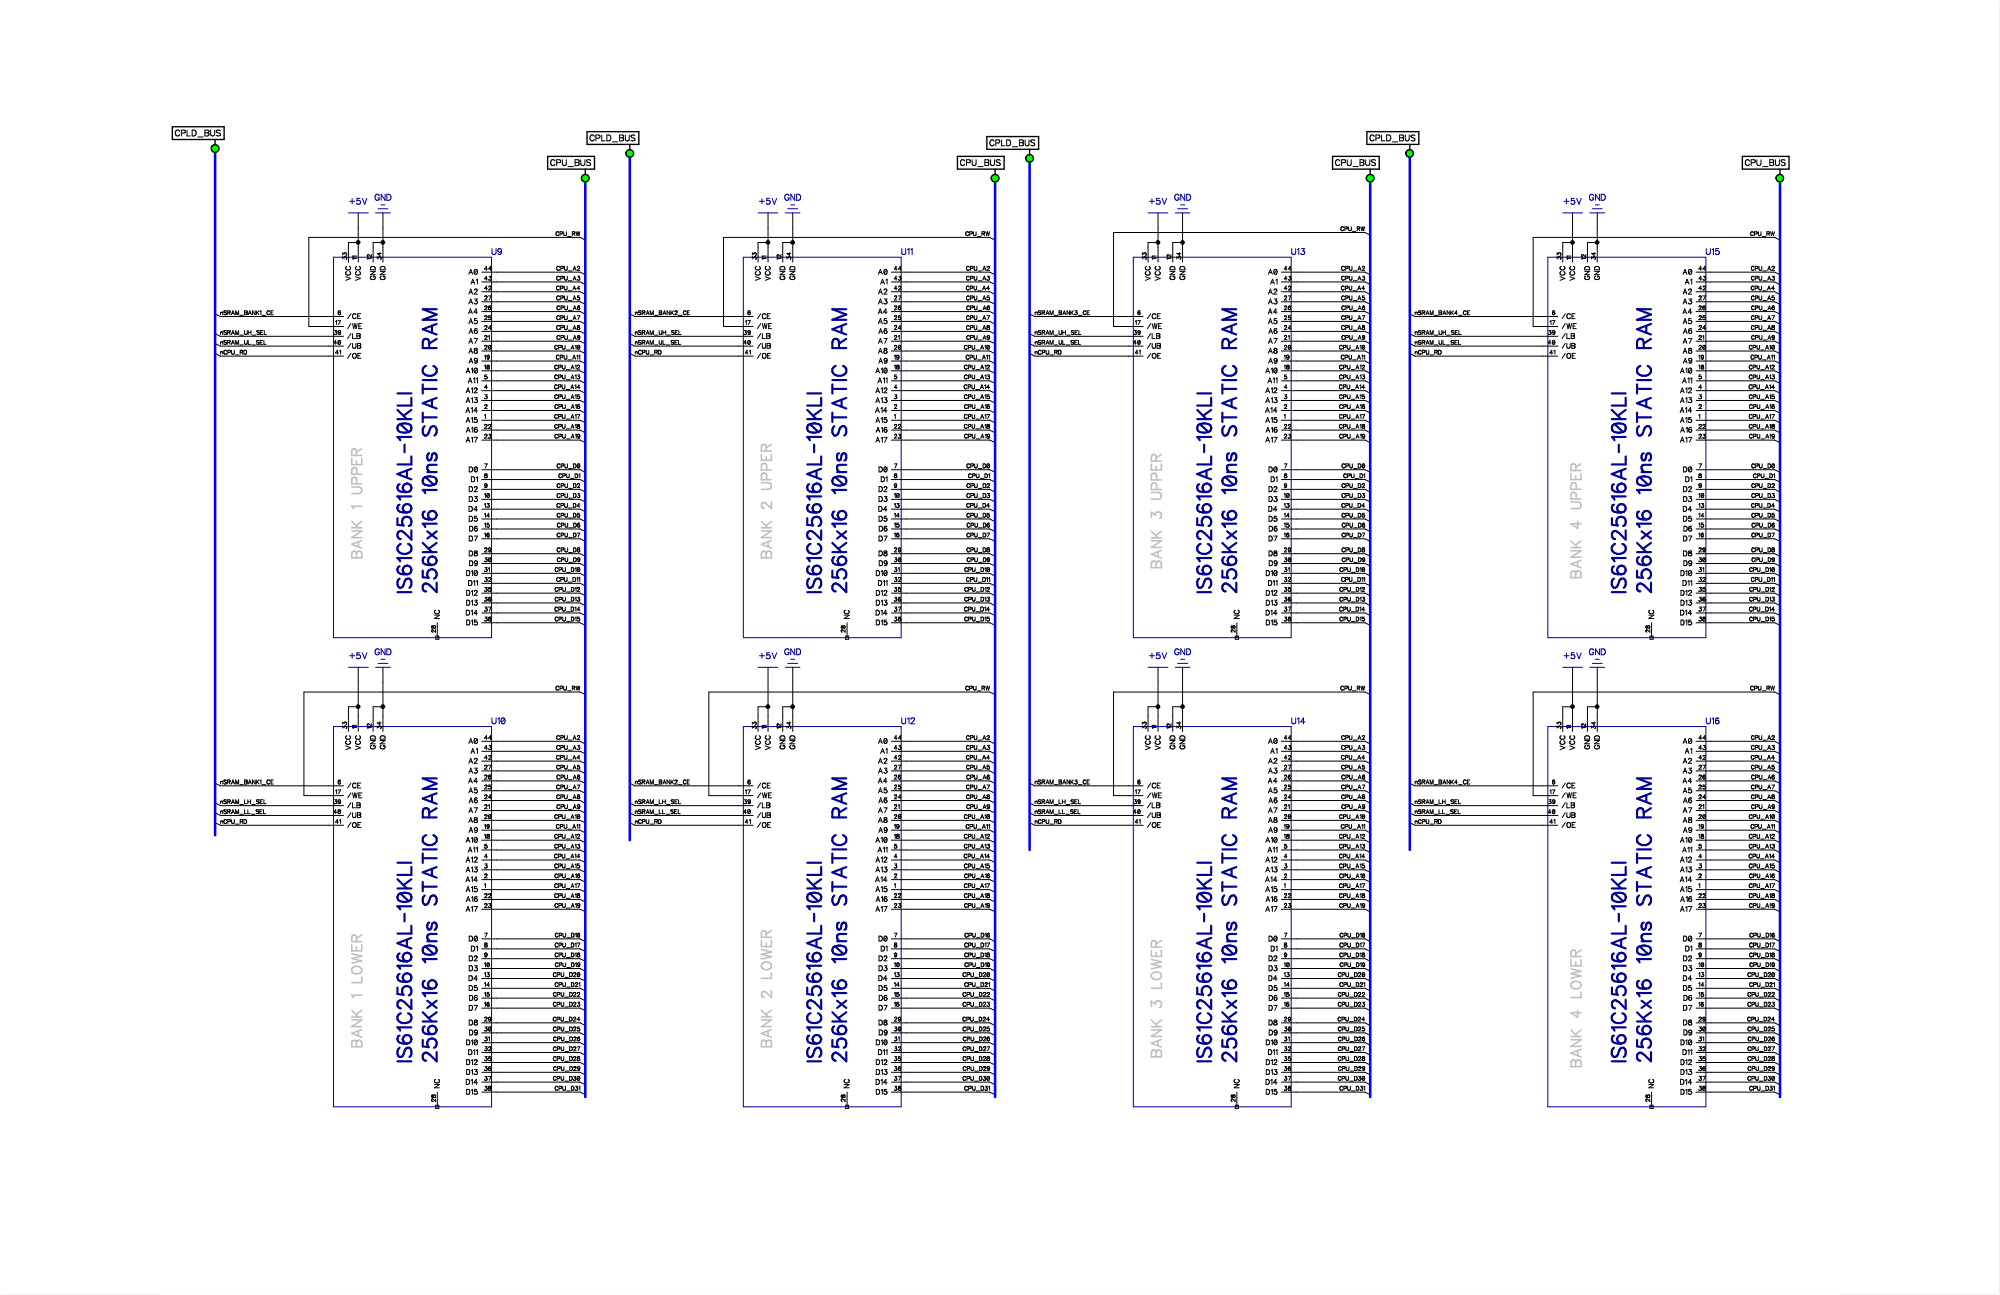
[picture p63: page 1]

BANK 1 UPPER BANK 1 LOWER

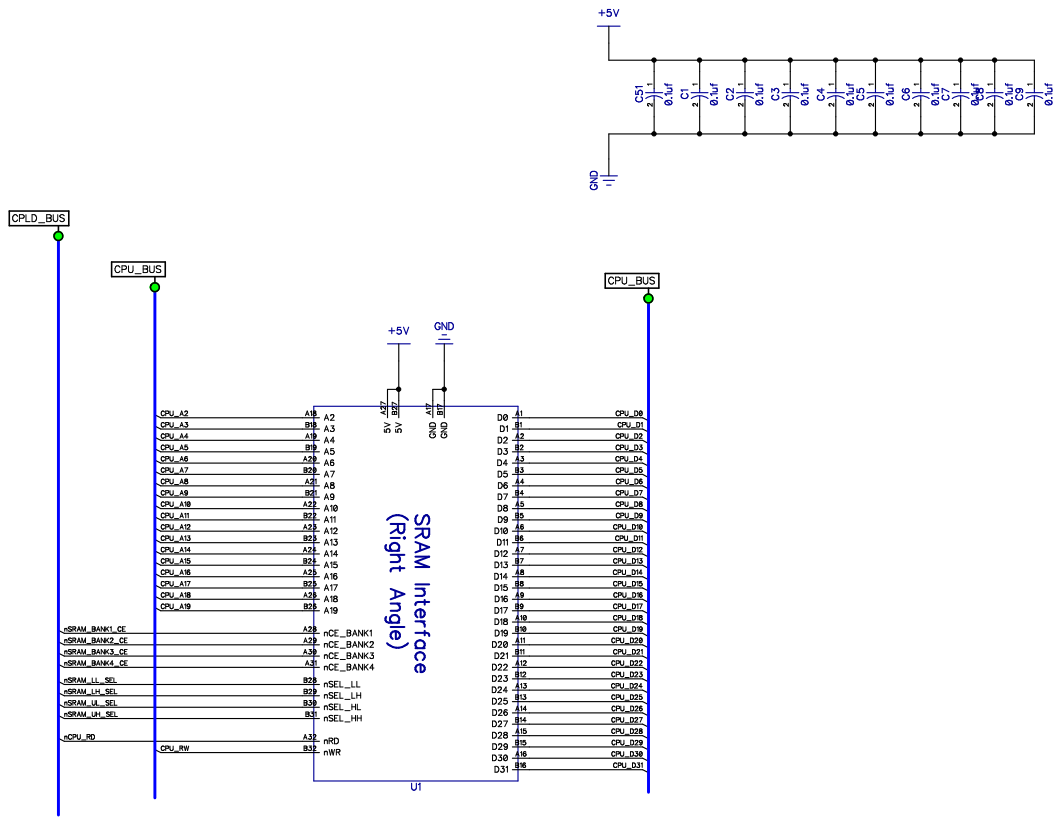
[picture p64: page 2]
