jeffsponaugle/roscoe/V2/V2PCBTop.pdf

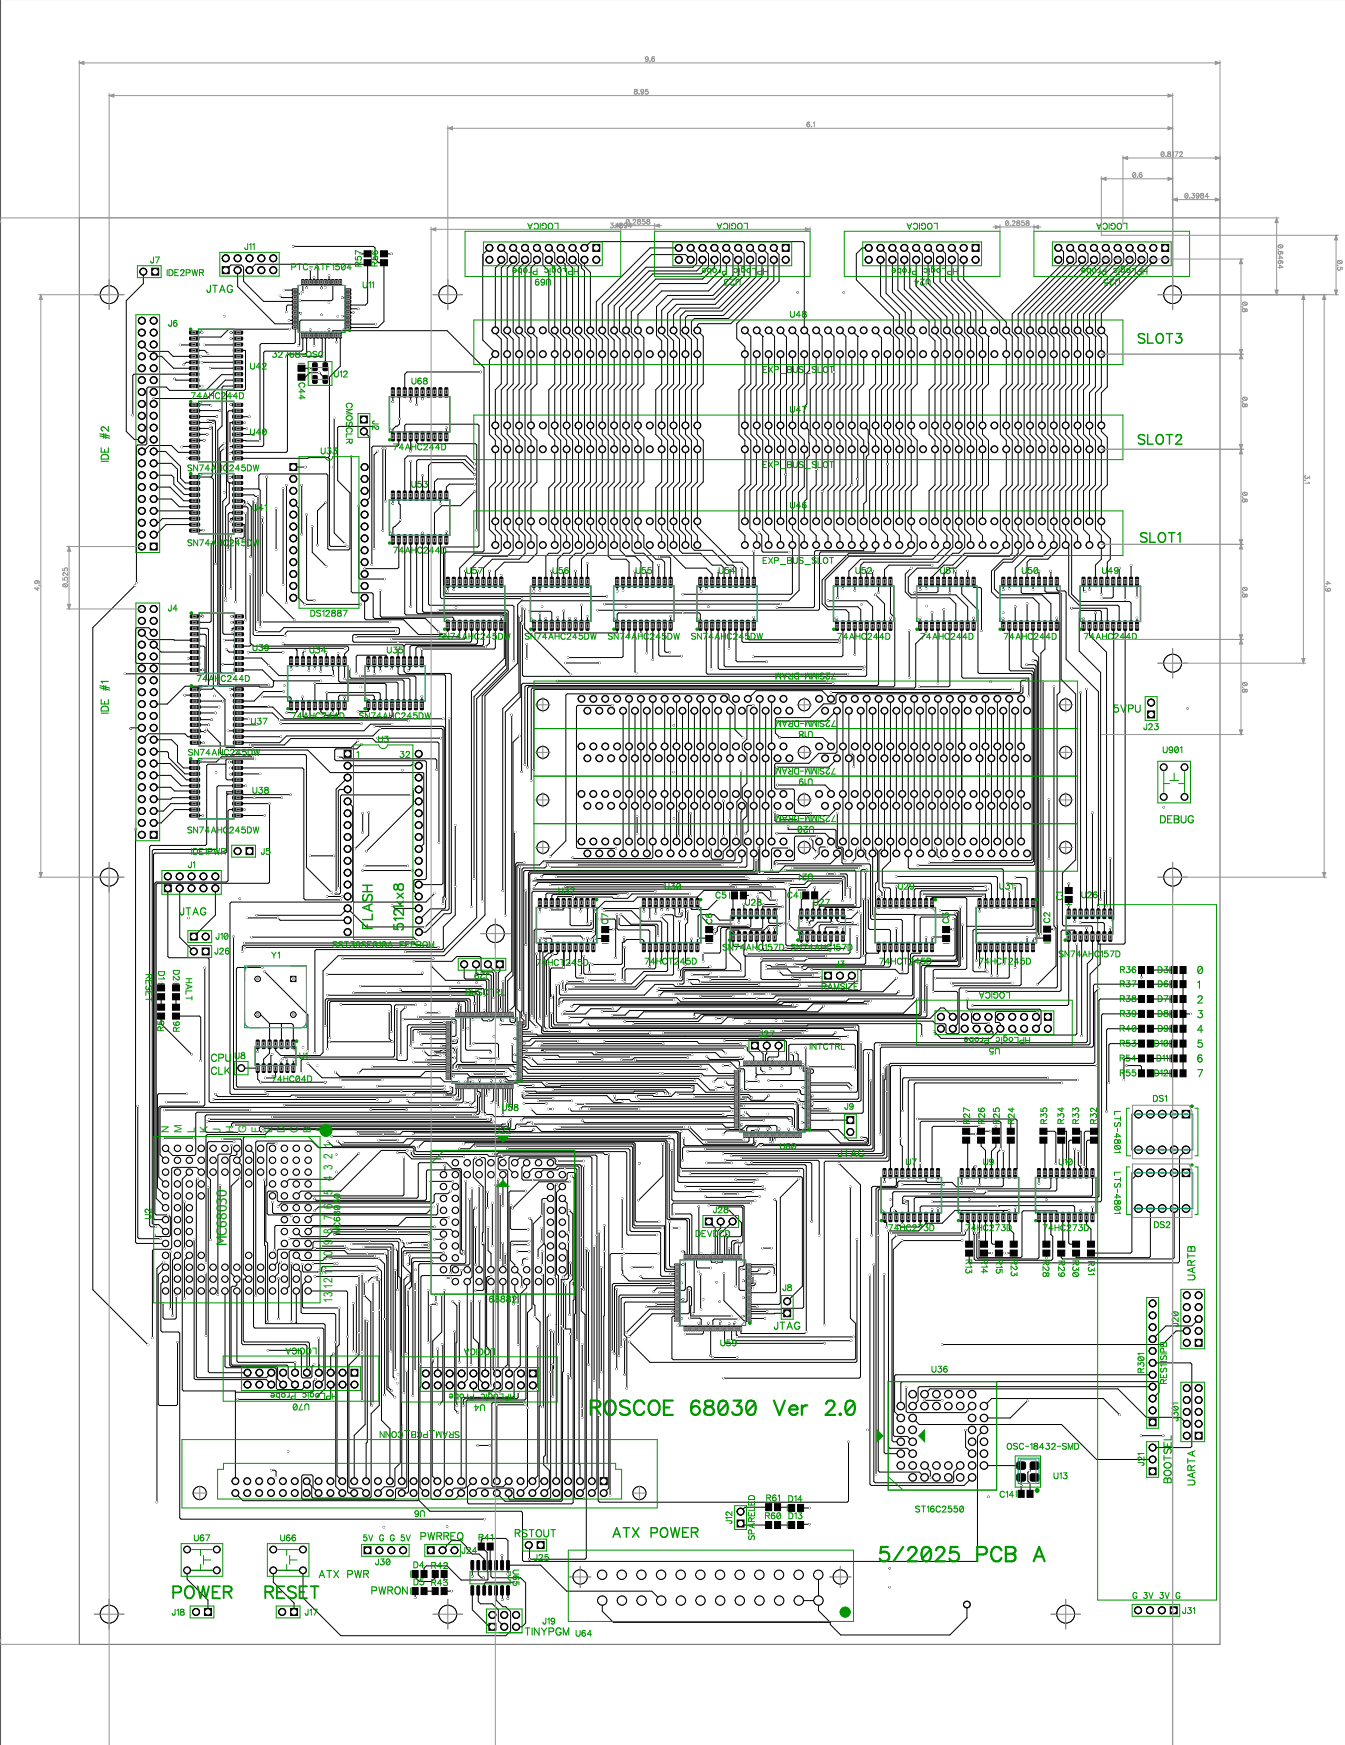
[picture p65: page 1]
