jeffsponaugle/roscoe/(list of files, drawings)

Other design files:
schematic/7SEGPOSTDISP.dch
schematic/7SegPOSTDisp.dip
schematic/ASORDERED/RoscoeMainboardV1.dch
schematic/ASORDERED/V2MainBoard/RoscoeMainboardV2.dch
schematic/ASORDERED/V2MainBoard/RoscoeSRAMboardPCBV2PreRoute.dip
schematic/ASORDERED/V2MainBoard/RoscoeSRAMboardPCBV2Route2.dip
schematic/ASORDERED/V2MainBoard/RoscoeSRAMboardPCBV2Route.dip
schematic/ASORDERED/V2MainBoard/RoscoeSRAMboardPCBV2RouteFinal.dip
schematic/ASORDERED/V2MainBoard/RoscoeSRAMboardV2.dch
schematic/ASORDERED/V2MainBoard/RoscoeV2PCBAutoRouteTest.dip
schematic/ASORDERED/V2MainBoard/RoscoeV2PCBPreAutoRoute.dip
schematic/NoFPU/ATXStartingPCB.dip
schematic/NoFPU/ATXStartingPCBS3.dip
schematic/NoFPU/RoscoeMainboardV1.dch
schematic/NoFPU/RoscoePCB.dip
schematic/NoFPU/RoscoePCBPREAR.dip
schematic/NoFPU/RoscoePCBRouteTest.dip
schematic/RoscoePCB.dip
schematic/RoscoePCBPreAutoRoute.dip
schematic/RoscoePCBRouteTest.dip
schematic/RoscoePOSTBoard.dip
schematic/RoscoePOSTDisplay.dch
schematic/RoscoeSRAMboardPCBV2Route2.dip
schematic/VGA/VGACardProtoStart.dip
schematic/VGA/VideoAdapterProto.dch
schematic/VGA/VideoAdapterRoscoe.dch
src/Roscoe/PowerControlModule/Power Control Module dev board/RSC68k-ATX.dch
src/Roscoe/PowerControlModule/Power Control Module dev board/RSC68k-ATX.dip
V1/OLD/7SEGPOSTDISP.dch
V1/OLD/NoFPU/ATXStartingPCBS3.dip
V1/OLD/RoscoePCBPostAutoRoute.dip
V1/OLD/RoscoePCBPostAutoRouteFixedUp.dip
V1/OLD/RoscoePCBPostAutoRouteFixedUpFINAL.dip
V1/OLD/RoscoePOSTBoard.dip
V1/OLD/RoscoePOSTDisplay.dch
V1/OLD/RoscoeSRAMboardPCBV2PreRoute.dip
V1/OLD/RoscoeV2PCBPreAutoRoute.dip
V1/RoscoePCBPostAutoRouteFixedUp3D.dip
V1/RoscoePCBPostAutoRouteFixedUpFINAL.dip
V1/RoscoePOSTBoard.dip
V2/schematic/ASORDERED/V2MainBoard/RoscoeMainboardV2Final.dch
V2/schematic/ASORDERED/V2MainBoard/RoscoeV2PCBAutoRouteFinsl.dip
V2/schematic/RoscoeSRAMboardPCBV2.dip
V2/schematic/VGA/AD7123Carrier.dch
V2/schematic/VGA/AD7123CarrierPCB.dip
V2/schematic/VGA/VGACard.dip
V2/schematic/VGA/VGACardProtoStartRouted.dip
V2/schematic/VGA/VideoAdapter.dch
