jeffsponaugle/roscoe/src/Roscoe/Emulator/Shared/z80/z80dasm.c

#include <stdio.h>
#include <string.h>
#include "Shared/Shared.h"

/* Z80dasm.c - a Z80 opcode disassembler */
/* Version 1.1 19-MAY-96 */
/* Copyright © 1996 Sean Riddle */

/* Freely distributable on any medium given all copyrights are retained */
/* by the author and no charge greater than $7.00 is made for obtaining */
/* this software */

/* Please send all bug reports, update ideas and data files to: */
/* sriddle@ionet.net */

/* latest version at: */
/* <a href="http://www.ionet.net/~sriddle">Please don't hurl on my URL!</a> */

/* the data files must be kept compatible across systems! */

/* usage: Z80dasm <file> [<data file>] */
/* output to stdout, so use redirection */

/* The optional data file contains 6 types of lines: */
/* o Remarks - these are lines beginning with a semi-colon (;) */
/*   they are completely ignored. */
/* o 1 ORG line - gives the origin of the code; this is the starting */
/*   address to be used for the disassembly. */
/* o COMMENT lines - used to add comments to the end of lines of the */
/*   disassembly. */
/* o COMMENTLINE lines - provide full-line comments to be included before */
/*   a given address in the disassembly. */
/* o DATA lines - mark sections as data.  These sections will not be */
/*   disassembled, but dumped as hex data instead. */
/* o ASCII lines - mark sections as text.  These sections will not be */
/*   disassembled, but printed as text instead. */

/* current limitations: */
/* o number of LABEL, DATA/ASCII, COMMENT and COMMENTLINE lines determined */
/*   at compile-time - see MAXLABEL, MAXDATA, MAXCOMMENT and MAXCOMMLINE */
/* o all DATA/ASCII lines in data file must be sorted in ascending */
/*   address order */
/* o ditto for COMMENT and COMMENTLINE lines */
/* o if a DATA/ASCII area is preceded by what Z80dasm thinks is code */
/*   that continues into the DATA/ASCII area, the data will not be marked */
/*   as such, and an error will be printed.  If this is the case, mark the */
/*   line before the data as data also. */

/* to do: */
/* o sort comment, ascii, data lines */
/* o look at JMP and JSR addresses- set to code unless overridden */
/*   in data file */
/* o perhaps a 'scan' that creates a first-guess .dat file? */
/*   generate dummy labels, mark code, find ASCII, etc. */

/* compiled on Amiga SAS/C 6.55 and Sun 10 Unix cc (and others) */

/* built from 6809dasm 1.5 */


/* a few of my datatypes (from Amiga) */
//typedef short BOOL;                                    /* boolean quantity */
typedef unsigned char UBYTE;                    /* unsigned 8-bit quantity */

/* array sizes for labels, DATA/ASCII definitions and COMMENT/COMMENTLINE */
#define MAXLABEL 999
#define MAXDATA 999                           /* both DATA and ASCII lines */
#define MAXCOMMENT 999
#define MAXCOMMLINE 999

/* output listing spacing */
#define TABOPNAME 15
#define TABOPERAND 20
#define TABCOMM 29

#define OPNAMETAB (TABOPNAME-1)
#define OPERANDTAB (TABOPERAND-1)
#define COMMTAB (TABCOMM-1)

typedef struct {                                       /* opcode structure */
   UBYTE opcode;                                     /* 8-bit opcode value */
   UBYTE numoperands;
   char name[15];                                           /* opcode name */
   UBYTE mode;                                          /* addressing mode */
   UBYTE numcycles;                                    /* number of cycles */
} opcodeinfo;
   
/* Z80 ADDRESSING MODES */
#define IMP 0           /* implied */
#define ABS_ADDR 1           /* absolute (extended) */
#define INDX 2          /* indexed x */
#define INDY 3          /* indexed y */
#define REL 4           /* relative */
#define EXT 5           /* external */
#define IMM 6           /* immediate */
#define INDIR 7         /* indirect */

/* page switches */
#define CBOP 9          /* cb page */
#define EDOP 10         /* ed page */

#define DDOP 11         /* dd page */
#define FDOP 12         /* fd page */
#define DDCBOP 13       /* ddcb page */
#define FDCBOP 14       /* fdcb page */

#define BITS 0x10          /* bits */
#define REG0 0x20          /* implicit 1 reg, bits 0-2 */
#define REG3 0x40          /* implicit 1 reg, bits 3-5 */
#define DBLREGS 0x80       /* implicit 2 regs */
#define CC1 0xA0            /* condition codes 1 */
#define CC2 0xC0            /* condition codes 2 */
  
/* number of opcodes in each page */
#define NUMOPS 84
#define NUMCBOPS 20
#define NUMDDOPS 28
#define NUMEDOPS 37
#define NUMFDOPS 28
#define NUMDDCBOPS 10
#define NUMFDCBOPS 10

int numops[7]={
   NUMOPS,NUMCBOPS,NUMEDOPS,NUMDDOPS,NUMFDOPS,NUMDDCBOPS,NUMFDCBOPS
};


char modenames[8][14]={       /* not used */
   "implied",
   "absolute",
   "xindexed",
   "yindexed",
   "relative",
   "external",
   "immediate",
   "indirect"
};

short useops[256]={           /* maps opcodes */
   0x0,0x1,0x2,0x3,0x4,0x5,0x6,0x7,0x8,0x9,0xa,0xb,0x4,0x5,0x6,0xf,
   0x10,0x1,0x12,0x3,0x4,0x5,0x6,0x17,0x18,0x19,0x1a,0xb,0x4,0x5,0x6,0x1f,
   0x20,0x1,0x22,0x3,0x4,0x5,0x6,0x27,0x20,0x29,0x2a,0xb,0x4,0x5,0x6,0x2f,
   0x20,0x1,0x32,0x3,0x34,0x35,0x36,0x37,0x20,0x39,0x3a,0xb,0x4,0x5,0x06,0x3f,
   0x40,0x40,0x40,0x40,0x40,0x40,0x46,0x40,0x40,0x40,0x40,0x40,0x40,0x40,0x46,0x40,
   0x40,0x40,0x40,0x40,0x40,0x40,0x46,0x40,0x40,0x40,0x40,0x40,0x40,0x40,0x46,0x40,
   0x40,0x40,0x40,0x40,0x40,0x40,0x46,0x40,0x40,0x40,0x40,0x40,0x40,0x40,0x46,0x40,
   0x70,0x70,0x70,0x70,0x70,0x70,0x76,0x70,0x40,0x40,0x40,0x40,0x40,0x40,0x46,0x40,
   0x80,0x80,0x80,0x80,0x80,0x80,0x86,0x80,0x88,0x88,0x88,0x88,0x88,0x88,0x8e,0x88,
   0x90,0x90,0x90,0x90,0x90,0x90,0x96,0x90,0x98,0x98,0x98,0x98,0x98,0x98,0x9e,0x98,
   0xa0,0xa0,0xa0,0xa0,0xa0,0xa0,0xa6,0xa0,0xa8,0xa8,0xa8,0xa8,0xa8,0xa8,0xae,0xa8,
   0xb0,0xb0,0xb0,0xb0,0xb0,0xb0,0xb6,0xb0,0xb8,0xb8,0xb8,0xb8,0xb8,0xb8,0xbe,0xb8,
   0xc0,0xc1,0xc2,0xc3,0xc4,0xc5,0xc6,0xc7,0xc0,0xc9,0xc2,0xcb,0xc4,0xcd,0xce,0xc7,
   0xc0,0xc1,0xc2,0xd3,0xc4,0xc5,0xd6,0xc7,0xc0,0xd9,0xc2,0xdb,0xc4,0xdd,0xde,0xc7,
   0xc0,0xc1,0xc2,0xe3,0xc4,0xc5,0xe6,0xc7,0xc0,0xe9,0xc2,0xeb,0xc4,0xed,0xee,0xc7,
   0xc0,0xc1,0xc2,0xf3,0xc4,0xc5,0xf6,0xc7,0xc0,0xf9,0xc2,0xfb,0xc4,0xfd,0xfe,0xc7,
};

opcodeinfo opcodes[NUMOPS]={
   0x00,0,"NOP",IMP,4,
   0x01,2,"LD",IMM|DBLREGS,10,
   0x02,0,"LD	(BC),A",INDIR,7,
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
   0xa6,1,"AND	A,",INDY,19,
   0xae,1,"XOR	A,",INDY,19,
   0xb6,1,"OR	A,",INDY,19,
   0xbe,1,"CP	A,",INDY,19,
   0xcb,0,"FDCB",FDCBOP,0,
   0xe1,0,"POP	IY",INDIR,14,
   0xe3,0,"EX	(SP),IY",INDIR,23,
   0xe5,0,"PUSH	IY",INDIR,15,
   0xe9,0,"JP	(IY)",IMP,8,
   0xf9,0,"LD	SP,IY",IMP,10,
};

short ddcbuseops[256]={
   -1,-1,-1,-1,-1,-1,6,-1,-1,-1,-1,-1,-1,-1,0xe,-1,-1,-1,-1,-1,-1,-1,0x16,-1,-1,-1,-1,-1,-1,-1,0x1e,-1,
   -1,-1,-1,-1,-1,-1,0x26,-1,-1,-1,-1,-1,-1,-1,0x2e,-1,-1,-1,-1,-1,-1,-1,-1,-1,-1,-1,-1,-1,-1,-1,0x3e,-1,
   -1,-1,-1,-1,-1,-1,0x46,-1,-1,-1,-1,-1,-1,-1,0x46,-1,-1,-1,-1,-1,-1,-1,0x46,-1,-1,-1,-1,-1,-1,-1,0x46,-1,
   -1,-1,-1,-1,-1,-1,0x46,-1,-1,-1,-1,-1,-1,-1,0x46,-1,-1,-1,-1,-1,-1,-1,0x46,-1,-1,-1,-1,-1,-1,-1,0x46,-1,
   -1,-1,-1,-1,-1,-1,0x86,-1,-1,-1,-1,-1,-1,-1,0x86,-1,-1,-1,-1,-1,-1,-1,0x86,-1,-1,-1,-1,-1,-1,-1,0x86,-1,
   -1,-1,-1,-1,-1,-1,0x86,-1,-1,-1,-1,-1,-1,-1,0x86,-1,-1,-1,-1,-1,-1,-1,0x86,-1,-1,-1,-1,-1,-1,-1,0x86,-1,
   -1,-1,-1,-1,-1,-1,0xc6,-1,-1,-1,-1,-1,-1,-1,0xc6,-1,-1,-1,-1,-1,-1,-1,0xc6,-1,-1,-1,-1,-1,-1,-1,0xc6,-1,
   -1,-1,-1,-1,-1,-1,0xc6,-1,-1,-1,-1,-1,-1,-1,0xc6,-1,-1,-1,-1,-1,-1,-1,0xc6,-1,-1,-1,-1,-1,-1,-1,0xc6,-1,
};

opcodeinfo ddcbopcodes[NUMDDCBOPS]={      /* !!! offset first! */
   0x06,1,"RLC",INDX,23,
   0x0e,1,"RRC",INDX,23,
   0x16,1,"RL",INDX,23,
   0x1e,1,"RR",INDX,23,
   0x26,1,"SLA",INDX,23,
   0x2e,1,"SRA",INDX,23,
   0x3e,1,"SRL",INDX,23,
   0x46,1,"BIT",INDX|BITS,20,
   0x86,1,"RES",INDX|BITS,23,
   0xc6,1,"SET",INDX|BITS,23,
};

short fdcbuseops[256]={
   -1,-1,-1,-1,-1,-1,6,-1,-1,-1,-1,-1,-1,-1,0xe,-1,-1,-1,-1,-1,-1,-1,0x16,-1,-1,-1,-1,-1,-1,-1,0x1e,-1,
   -1,-1,-1,-1,-1,-1,0x26,-1,-1,-1,-1,-1,-1,-1,0x2e,-1,-1,-1,-1,-1,-1,-1,-1,-1,-1,-1,-1,-1,-1,-1,0x3e,-1,
   -1,-1,-1,-1,-1,-1,0x46,-1,-1,-1,-1,-1,-1,-1,0x46,-1,-1,-1,-1,-1,-1,-1,0x46,-1,-1,-1,-1,-1,-1,-1,0x46,-1,
   -1,-1,-1,-1,-1,-1,0x46,-1,-1,-1,-1,-1,-1,-1,0x46,-1,-1,-1,-1,-1,-1,-1,0x46,-1,-1,-1,-1,-1,-1,-1,0x46,-1,
   -1,-1,-1,-1,-1,-1,0x86,-1,-1,-1,-1,-1,-1,-1,0x86,-1,-1,-1,-1,-1,-1,-1,0x86,-1,-1,-1,-1,-1,-1,-1,0x86,-1,
   -1,-1,-1,-1,-1,-1,0x86,-1,-1,-1,-1,-1,-1,-1,0x86,-1,-1,-1,-1,-1,-1,-1,0x86,-1,-1,-1,-1,-1,-1,-1,0x86,-1,
   -1,-1,-1,-1,-1,-1,0xc6,-1,-1,-1,-1,-1,-1,-1,0xc6,-1,-1,-1,-1,-1,-1,-1,0xc6,-1,-1,-1,-1,-1,-1,-1,0xc6,-1,
   -1,-1,-1,-1,-1,-1,0xc6,-1,-1,-1,-1,-1,-1,-1,0xc6,-1,-1,-1,-1,-1,-1,-1,0xc6,-1,-1,-1,-1,-1,-1,-1,0xc6,-1,
};

opcodeinfo fdcbopcodes[NUMFDCBOPS]={      /* !!! offset first! */
   0x06,1,"RLC",INDY,23,
   0x0e,1,"RRC",INDY,23,
   0x16,1,"RL",INDY,23,
   0x1e,1,"RR",INDY,23,
   0x26,1,"SLA",INDY,23,
   0x2e,1,"SRA",INDY,23,
   0x3e,1,"SRL",INDY,23,
   0x46,1,"BIT",INDY|BITS,20,
   0x86,1,"RES",INDY|BITS,23,
   0xc6,1,"SET",INDY|BITS,23,
};

opcodeinfo *pgpointers[7]={
   opcodes,cbopcodes,edopcodes,ddopcodes,fdopcodes,ddcbopcodes,fdcbopcodes
};

short *usepointers[7]={
   useops,cbuseops,eduseops,dduseops,fduseops,ddcbuseops,fdcbuseops
};

int count;                             /* current program counter for disasm */
unsigned char *Memory = NULL;

static UINT8 *pbPtr = NULL;
static INT32 dwLen = 0;
static UINT8 opcodeList[5];

static int getbyte() 
{
	opcodeList[dwLen++] = *pbPtr;
	++pbPtr;
	return(opcodeList[dwLen-1]);
}

/* ungetbyte() - put a byte back to a file, decrement byte counter */
void ungetbyte() 
{
	--pbPtr;
	--dwLen;
}

const char *regs[8]={"B","C","D","E","H","L","(HL)","A"};
const char *dregs[7]={"BC","DE","HL","SP","AF","IX","IY"};
const char *flags[8]={"NZ","Z","NC","C","PO","PE","P","M"};
      
#define LABELSIZE 40
/* label structure */
struct lastruct {
   unsigned short lab;                                    /* label address */
   char label[LABELSIZE];                                    /* label text */
} *labarray=NULL;
int numlab=0;                                  /* number of labels defined */

/* hmmm, these aren't ANSI */
/* stricmp() - compare two strings, case insensitive */
/*int stricmp(const char *s1, const char *s2) {
   for(;toupper(*s1)==toupper(*s2);++s1,++s2)
      if(*s1=='\0')
         return(0);
   return((toupper(*(unsigned char *)s1)<toupper(*(unsigned char *)s2))?-1:1);
}
*/

char labtemp[30];                   /* global return for checklabs() - tsk */

/* checklabs() - check the defined labels from data file */
/* substitute label for address if found */
char *checklabs(int address,BOOL lab2,BOOL printdollar) {
   int i;
   
   address&=0xffff;
   labtemp[0]='\0';
   for(i=0;i<numlab;i++)
      if(address==labarray[i].lab) {
         sprintf(labtemp,"%s",labarray[i].label);
         if(lab2)
            strcat(labtemp,":\n");
         i=numlab;
      }
   if(!strlen(labtemp)&&!lab2) {
      if(printdollar)
         sprintf(labtemp,"$%04hX",address);
      else
         sprintf(labtemp,"%04hX",address);
   }
   return(labtemp);
}

/* printoperands() - print operands for the given opcode */
void printoperands(int page,int opcode,UBYTE numoperands,UBYTE *operandarray,
      UBYTE mode,char *opname,char *str) {
   int rel;
   char out2[80];
   int r;
   BOOL printdollar=FALSE;           /* print a leading $ before address? */
   BOOL printpound=FALSE;
   UBYTE printcomma=0;
   BOOL printpar=FALSE;
   BOOL indx=FALSE;
   char lastchar=opname[strlen(opname)-1];

   switch(mode&0xf0) {
      case BITS:
         if(!strcmp(opname,"RST")) {
            sprintf(out2,"$%02.2X",((opcode>>3)&7)*8);
            strcat(str,out2);
         } else if((mode&0xf)==INDIR) {
            sprintf(out2,"%d,(HL)",(opcode>>3)&7);
            strcat(str,out2);
         } else if(((mode&0xf)==INDX)||((mode&0xf)==INDY)) {
            sprintf(out2,"%d",(opcode>>3)&7);
            strcat(str,out2);
            printcomma=1;
         }
         break;
      case REG0|REG3:
         strcat(str,regs[(opcode>>3)&7]);
         strcat(str,",");
         strcat(str,regs[opcode&7]);
         break;
         
      case BITS|REG0:
         sprintf(out2,"%d,",(opcode>>3)&7);
         strcat(str,out2);
      case REG0:
         if(!(((page==FDOP)||(page==DDOP))&&
               ((opcode<=0x77)&&(opcode>=0x70)))) {
            strcat(str,regs[opcode&7]);
            printcomma=1;
         }
         break;
         
      case REG3:
         printcomma=1;
         if(((mode&0xf)==EXT)&&!strcmp(opname,"OUT")) {
            strcat(str,"(C),");
            printcomma=2;
         }
         strcat(str,regs[(opcode>>3)&7]);
         break;
       case DBLREGS:
         r=(opcode>>4)&3;
         if((!strcmp(opname,"PUSH")||!strcmp(opname,"POP"))&&(r==3))
            r++;
         if(!strncmp(opname,"ADD   I",7)&&(r==2)) {
            if(opname[7]=='X')
               r+=3;
            else
               r+=4;
         }
         if(!((page==EDOP)&&
               ((opcode==0x43)||(opcode==0x53)||(opcode==0x73)))) {
            strcat(str,dregs[r]);
            printcomma=1;
         }
         break;
       case CC1:
         strcat(str,flags[(opcode>>3)&7]);
         printcomma=1;
         break;
       case CC2:
         strcat(str,flags[(opcode>>3)&3]);
         printcomma=1;
         break;
       default:
         break;
   }
   switch(mode&0xf) {
    case REL:                                          /* 8-bit relative */
         if(printcomma==1) {
            strcat(str,",");
            printcomma=2;
         }
         rel=operandarray[0];
         sprintf(out2,checklabs((short)(count+((rel<128) ? rel : rel-256)),
               FALSE,TRUE));
         strcat(str,out2);
         break;

      case IMM:
         printpound=TRUE;
      case EXT:
         printdollar=TRUE;
      case ABS_ADDR:
      case IMP:
         if(((mode&0xf)==ABS_ADDR)||((mode&0xf)==EXT))
            printpar=TRUE;
         strcpy(out2,"");
         if((numoperands==1)||(numoperands==2)) {
            if(printcomma==1) {
               strcat(str,",");
               printcomma=2;
            }
            if(printpar)
               strcat(str,"(");
            if(numoperands==1) {
               if(printpound)
                  strcat(str,"#");
               if(printdollar)
                  strcat(str,"$");
               sprintf(out2,"%02.2X",operandarray[0]);
            } else if(numoperands==2)
               sprintf(out2,checklabs((operandarray[1]<<8)+operandarray[0],
                     FALSE,TRUE));
            strcat(str,out2);
            if(printpar)
               strcat(str,")");
         } else {
            if(((mode&0xf)==EXT)&&!strcmp(opname,"IN")) {
               if(printcomma==1) {
                  strcat(str,",(C)");
                  printcomma=2;
               }
            }
         }
         break;
      case INDX:
         indx=TRUE;
      case INDY:
            if(printcomma==1) {
               strcat(str,",");
               printcomma=2;
            }
            sprintf(out2,"(I%c+$%02.2X)",(indx?'X':'Y'),
                  operandarray[0]);
            strcat(str,out2);
         break;
      default:
         break;
   }
   if(printcomma<2) {
      switch(mode&0xf) {
         case INDX:
         case INDY:
            if((mode&0xf0)==REG0) {
               strcat(str,",");
               strcat(str,regs[opcode&7]);
            } else if(numoperands==2) {
               sprintf(out2,",#$%02.2X",operandarray[1]);
               strcat(str,out2);
            }
            break;
            
         case INDIR:
            if(mode==(INDIR|REG3))
               strcat(str,",(HL)");
            if(((lastchar==',')&&(strcmp(&opname[strlen(opname)-5],"(HL),")))||
                  (!strcmp(opname,"RL")||!strcmp(opname,"RRC")||
                  !strcmp(opname,"SLA")||!strcmp(opname,"SRA")||
                  !strcmp(opname,"SRL")||!strcmp(opname,"RR")))
               strcat(str,"(HL)");
            break;
         case ABS_ADDR:
            if((mode&0xf0)==DBLREGS) {
               strcat(str,",");
               strcat(str,dregs[(opcode>>4)&3]);
            } else if(opcode==0x22) {
               if(page==0)
                  strcat(str,",HL");
               else if(page==DDOP)
                  strcat(str,",IX");
               else if(page==FDOP)
                  strcat(str,",IY");
            } else if(opcode==0x32)
               strcat(str,",A");
               
         case EXT:
            if(((lastchar!=',')&&(lastchar!='R')&&(lastchar!='I')&&
                  (lastchar!='D')))
               strcat(str,",A");
            break;
      }
   }


}

#define DATA 0                                  /* type of data to display */
#define ASCII 1

/* DATA/ASCII structure definition */
struct dastruct {
   unsigned short start;                /* beginning address of DATA/ASCII */
   unsigned short end;                                   /* ending address */
   unsigned short per_line;                   /* values to print on a line */
   short type;                                           /* DATA or ASCII ? */
} *dataarray=NULL;

#define COMMENTSIZE 80
/* COMMENT/COMMENTLINE structure definition */
struct castruct {
   unsigned short comline;                         /* comment line address */
   char comment[COMMENTSIZE];                              /* comment text */
} *commarray=NULL,*commlinearray=NULL;

char out[512],out2[80];                             /* temp string buffers */

BOOL newl=FALSE;
BOOL diddata=FALSE;

void z80DasmShutdown(void) 
{
}

UINT32 z80DasmSetup(void)
{
	return(TRUE);
}

UINT32 z80DisassembleOne(UINT32 address, 
				UINT8 *data, 
				UINT8 *pszOpcodeBytes, 
				UINT8 *pszOperation,
				UINT8 *pszArgument)
{
	INT32 i, j, k;
	UINT8 opcode;
	UINT8 temp;

   int page;
   UBYTE operand[4];
   opcodeinfo *op;
   int numoperands;
	

	pbPtr = data;
	dwLen = 0;
	opcode = getbyte();
	count = address + 2;

	*pszOpcodeBytes = '\0';
	*pszOperation = '\0';
	*pszArgument = '\0';

   for(i=0;(i<numops[0])&&(opcodes[i].opcode!=useops[opcode]);
           i++)
          ;

   if((opcodes[i].mode&0x0f)>=CBOP)
	{      /* page switch */
      opcode=getbyte();
      page=opcodes[i].mode-CBOP+1;          /* get page # */
      if((opcodes[i].mode==DDOP)||(opcodes[i].mode==FDOP))
		{
         if(opcode==0xcb)
	   	{  /* operand first */
            page+=2;
            temp=getbyte();
            opcode=getbyte();
            ungetbyte();
      	}
   	}

	   for(k=0;(k<numops[page])&&(usepointers[page][opcode]!=pgpointers[page][k].opcode);k++);

	   if(k!=numops[page])
	   {                 /* opcode found */
	      op=(opcodeinfo *) &(pgpointers[page][k]);
	      numoperands=pgpointers[page][k].numoperands;
	      for(j=0;j<numoperands;j++)
		   {
				operand[j] = getbyte();
	      }
	
			strcpy(pszOperation, pgpointers[page][k].name);

			j = 0;
			while (pszOperation[j] != '\t' &&
					 pszOperation[j] != '\0')
			{
				j++;
			}
	
			if (pszOperation[j] == '\t')
			{
				pszOperation[j] = '\0';
				strcpy(pszArgument, &pszOperation[j + 1]);
			}

			pszArgument += strlen(pszArgument);

	      printoperands(page+CBOP-1,
							  opcode,
							  numoperands,
	            		  operand,
							  pgpointers[page][k].mode,
	            		  pgpointers[page][k].name,
							  pszArgument); 
	   }
		else
		{               /* not found in alternate page */
			strcpy(pszOperation, "???");
	   }
	}
	else
   {                                /* page 1 opcode */
      op=(opcodeinfo *) &(opcodes[i]);
      numoperands=opcodes[i].numoperands;
      for(j=0;j<numoperands;j++)
		{
			operand[j] = getbyte();
      }

		strcpy(pszOperation, opcodes[i].name);

		j = 0;
		while (pszOperation[j] != '\t' &&
				 pszOperation[j] != '\0')
		{
			j++;
		}

		if (pszOperation[j] == '\t')
		{
			pszOperation[j] = '\0';
			strcpy(pszArgument, &pszOperation[j + 1]);
		}

		pszArgument += strlen(pszArgument);

      printoperands(0,
						  opcode,
						  numoperands,
						  operand,
            		  opcodes[i].mode,
						  opcodes[i].name,
						  pszArgument);
   }
 
	for (i = 0; i < 4; i++)
	{
		if (i >= dwLen)
		{
			strcpy(pszOpcodeBytes, "   ");
		}
		else
		{
			sprintf(pszOpcodeBytes, "%.2x ", opcodeList[i]);
		}

		pszOpcodeBytes += 3;
	}	

	*pszOpcodeBytes = '\0';
	return(dwLen);
}
