jeffsponaugle/roscoe/(commit log)

2024-04-01 Device Control PLD added
2024-04-01 Device Control PLD added compiled
2024-04-01 Schematic Libraries
2024-04-02 Interrupt Controller Created
2024-04-02 Interrupt Controller Updated
2024-04-04 First Schematic Draft w CPU
    [RoscoeMainboardV1.dch]
2024-04-05 Added Flash to sch
    [RoscoeMainboardV1.dch]
2024-04-05 ATX Starting PCB
    [ATXStartingPCB.dip]
2024-04-06 DRAM Added to Schematic
    [RoscoeMainboardV1.dch]
2024-04-06 SLOT Adapter
    [RoscoeMainboardV1.dch]
2024-04-06 bus added
    [RoscoeMainboardV1.dch]
2024-04-08 EdgeCard Routed
    [RoscoePCB.dip]
2024-04-12 PCB Routing
    [RoscoeMainboardV1.dch, RoscoePCB.dip]
2024-04-14 Updated Schematics
    [RoscoeMainboardV1.dch, RoscoePCB.dip]
2024-04-18 Route Testing
    [RoscoePCB.dip, RoscoePCBPREAR.dip, RoscoePCBRouteTest.dip]
2024-04-18 Updated Routed A
    [RoscoePCB.dip, RoscoePCBRouteTest.dip]
2024-04-18 Silkscreen Fixes
    [RoscoeMainboardV1.dch, RoscoePCB.dip]
2024-04-19 Removed 4 DIMMS
    Removed 4 DIMMS to make room for FPU
    [ATXStartingPCB.dip, ATXStartingPCBS3.dip, RoscoeMainboardV1.dch, RoscoePCB.dip, RoscoePCBPREAR.dip, RoscoePCBRouteTest.dip]
2024-04-19 Added FPU
    [RoscoeMainboardV1.dch, RoscoePCB.dip]
2024-04-20 Updated Routable Schematic
    [RoscoePCB.dip]
2024-04-20 Added LOGICA
    Logic Connectors
    [RoscoeMainboardV1.dch, RoscoePCB.dip]
2024-04-20 Added EXP CPLD connections
    [RoscoeMainboardV1.dch, RoscoePCB.dip, RoscoePCBRouteTest.dip]
2024-04-20 Final Updates Pre Route
    Final Updates pre autoroute
    [RoscoeMainboardV1.dch, RoscoePCB.dip, RoscoePCBRouteTest.dip]
2024-04-20 ReadyToOrderPCB
    PCB Ready to Order
    [RoscoeMainboardV1.dch, RoscoePCB.dip, RoscoePCBPreAutoRoute.dip, RoscoePCBRouteTest.dip]
2024-04-20 Gerber
    Gerber Used for Order added
    [RoscoeMainboardV1.dch]
2024-04-21 Ordered PCBS
    [RoscoePOSTBoard.dip, RoscoePOSTDisplay.dch]
2024-04-21 Create BOM.csv
    Bill of Materials
    [BOM.csv]
2024-04-21 PLD Code fixes.
    [BOM.csv, BOM.xlsx]
2024-04-21 Update BOM.csv
    BOM
    [BOM.csv]
2024-04-23 VGA Card Started
    [VideoAdapter.dch]
2024-04-23 Video
    Video
    [VideoAdapter.dch]
2024-04-28 Video updates
    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
    [VideoAdapter.dch]
2024-04-28 Reverse Device CS
    Device CS Fix
2024-05-24 new src checkin
    [RSC68k-ATX.dch, RSC68k-ATX.dip, mkfs.xlsx, modules.cfg]
2024-06-14 Interrupt Updates
2025-04-24 V2 Updates
    [RoscoeMainboardV2.dch, RoscoeSRAMboardPCBV2.dip, RoscoeSRAMboardPCBV2PreRoute.dip, RoscoeSRAMboardPCBV2Route.dip, RoscoeSRAMboardPCBV2Route2.dip, RoscoeSRAMboardV2.dch]
2025-05-20 PTC updates
    [RoscoeMainboardV2.dch]
2025-05-22 PTC pin mapped
    [RoscoeMainboardV2.dch, RoscoeV2PCBPreAutoRoute.dip]
2025-05-23 V2 PCB and PLD
    [RoscoeMainboardV2.dch, RoscoeV2PCBPreAutoRoute.dip]
2025-06-01 cpld flash
    [DebugPinouts.xlsx]
2025-07-08 Fixed Interrupt Vector Generation
2025-07-23 Testing Bad PCB
2025-07-23 new src
    [RSC68k-ATX.dch, RSC68k-ATX.dip, mkfs.xlsx, modules.cfg]
2025-07-23 updated src
    [RSC68k-ATX.dch, RSC68k-ATX.dip, mkfs.xlsx, modules.cfg]
2025-07-31 Schematics PDFs
2025-10-29 VGA Updates
    [AD7123Carrier.dch, AD7123CarrierPCB.dip, VGACard.dip, VGACardProtoStart.dip, VideoAdapterProto.dch]
2025-10-30 128MB SIMM Supported added
    128MB commented out, must be switched and recompiled to use.
2026-01-15 Updated VGA Sc
    [VideoAdapterProto.dch]
2026-07-04 CPU_RD Patch Del;ayed
    [VGACardProtoStart.dip, VGACardProtoStartRouted.dip, VideoAdapterRoscoe.dch]
2026-07-04 Video Schematic update
2026-07-07 Added Debug Pins
    [VGACardProtoStartRouted.dip, VideoAdapterRoscoe.dch]
2026-10-18 physical patches to PCB
